dario0603/AudioAnalogMixer/README.md

# Analog Audio Mixer

<p align="left">
  
  
  
</p>

## Overview

Design and development of a **modular analog audio mixer**, combining circuit simulation and PCB design. The project focuses on audio signal conditioning, equalization, level control, and the integration of multiple input channels into a modular mixer architecture.

The design is divided into two main development areas:

- **LTspice simulations:** individual analog circuit blocks are simulated and evaluated before hardware implementation.
- **KiCad designs:** modular PCB boards are developed to organize the mixer circuitry into functional sections.

The current design includes microphone/line signal conditioning, a three-band equalizer, level and FX-send circuitry, a clipping indicator, and a four-channel mixer board.

The project is still under development. Circuit design, simulation, and PCB integration are ongoing, and the current files should be considered work in progress rather than a finalized hardware design.

## System Architecture

The mixer is organized into modular functional blocks. This approach makes it possible to develop and test each section independently before integrating the complete system.
The input stage provides microphone and line-level signal conditioning. Separate configurations are included for a single microphone/line channel and for two line-level channels, intended for left and right stereo signals.

The signal-conditioning section includes:

- Microphone/line preamplification.
- Three-band tone control.
- Output-level adjustment.
- FX-send circuitry.

### 1. Microphone/Line Preamplifier Circuit

The microphone/line preamplifier circuit provides input signal conditioning and amplification for low-level microphone signals and line-level audio sources. It is designed to adapt different input signal levels to the following stages of the mixer, ensuring proper signal amplification and compatibility with the audio processing circuitry.

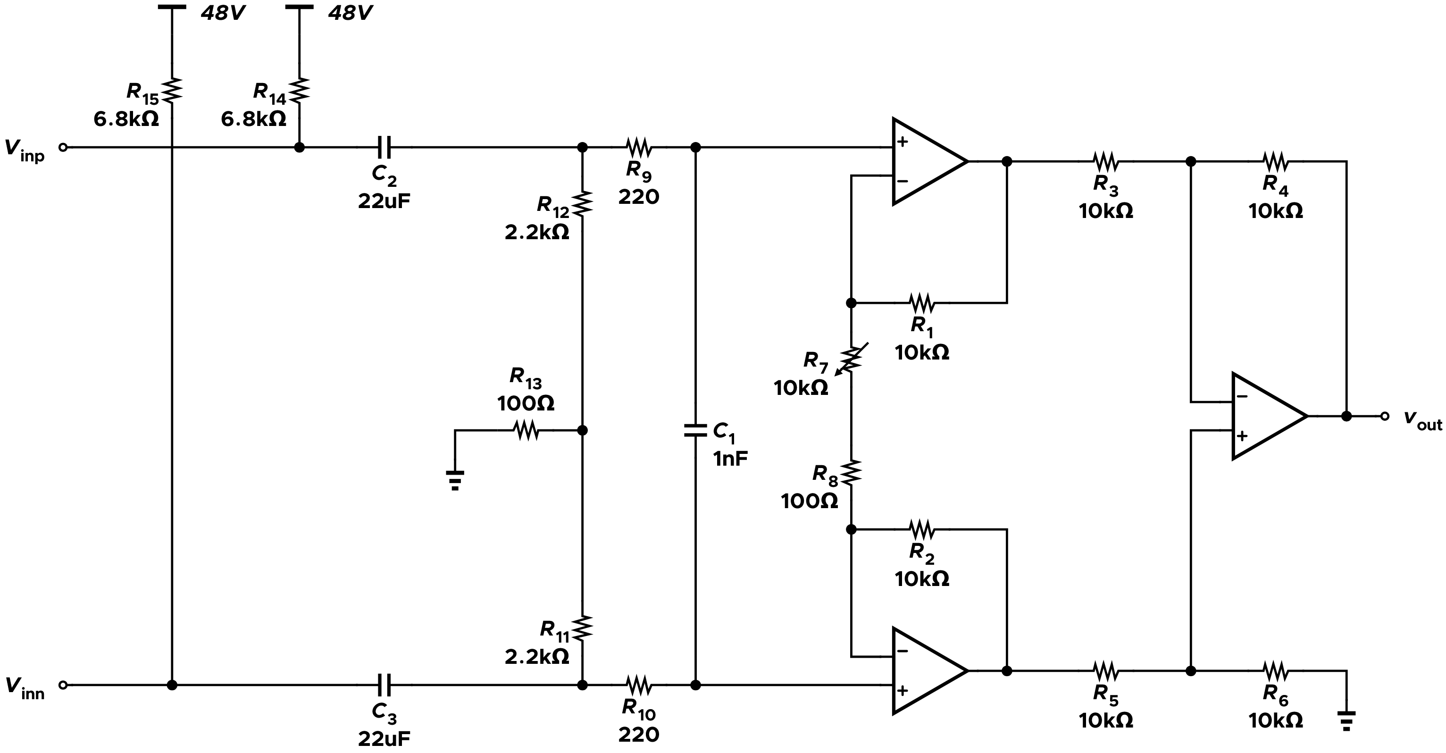
[picture p1: img/mic-line-amplifier.png]
Microphone and line amplifier


### 2. Three-Band Equalizer

The three-band equalizer provides independent control over the low-, mid-, and high-frequency portions of the audio spectrum.

The frequency response is evaluated through LTspice AC analysis. Different equalizer settings are compared to investigate how the circuit affects the audio signal across the frequency range.

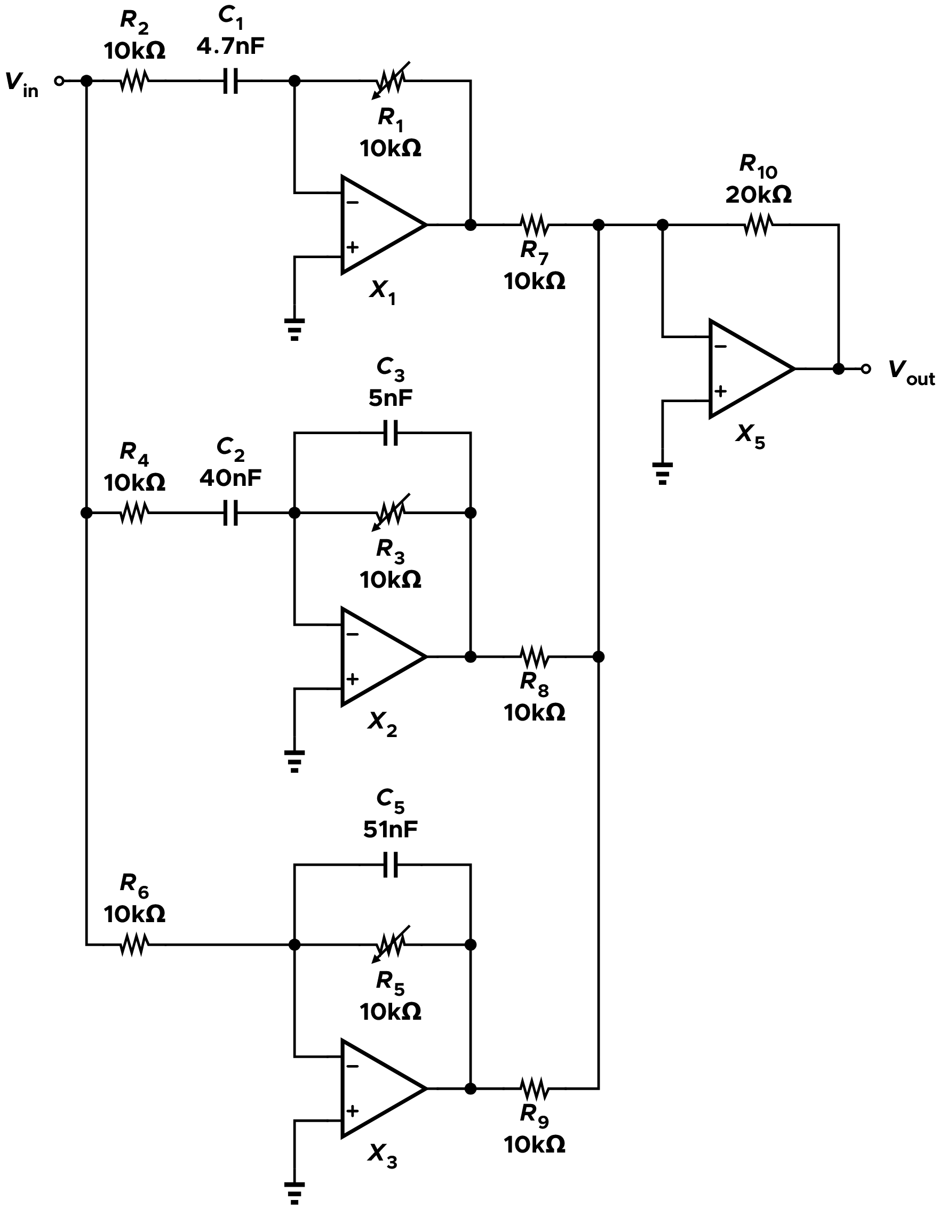
[picture p2: img/3-band-equalizer.png]
Three-band audio equalizer


### 3. Mixer Unit

This stage combines the signals processed by the input stages (microphone/line preamplifier and three-band equalizer), summing the individual channels to generate the final audio output. The output is provided in differential mode through two dedicated buffer amplifiers, ensuring proper signal driving capability and output impedance.

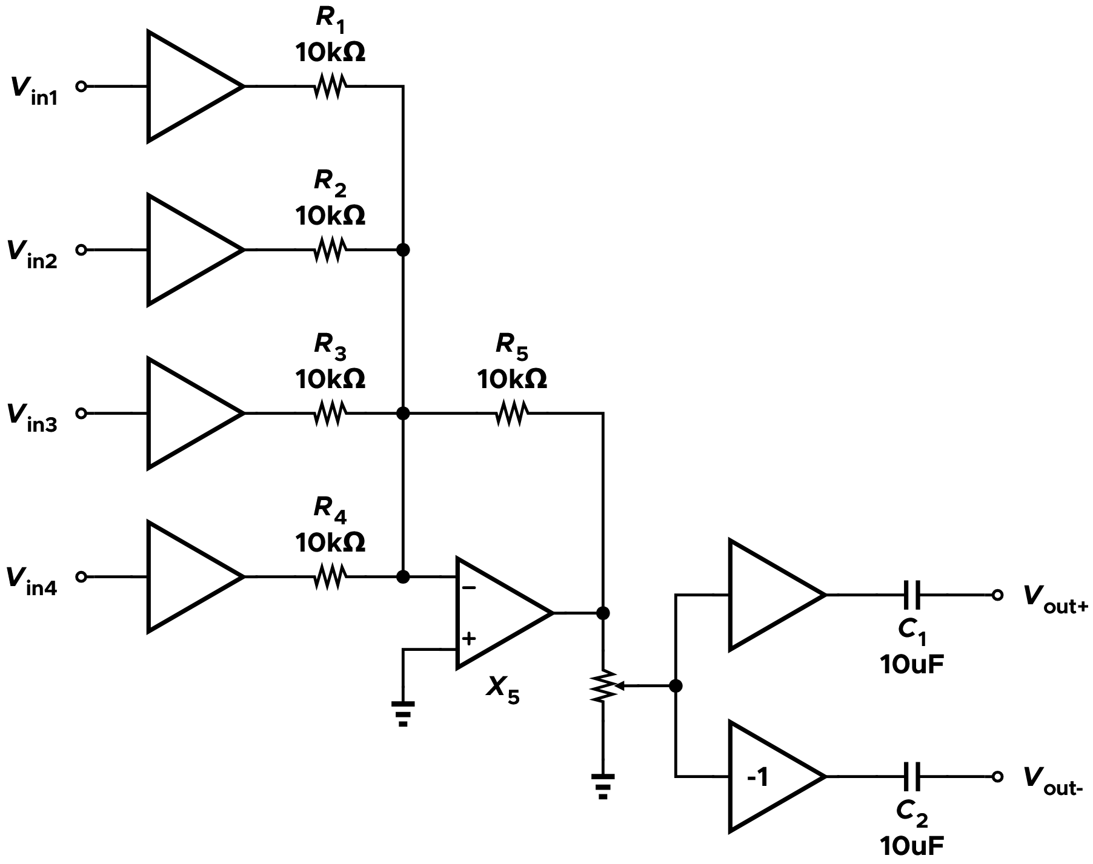
[picture p3: img/4channmixer.png]
Mixer unit


### 4. Clipping Indicator

A dedicated clipping-indicator circuit is included in the LTspice project.

The circuit uses an LM393 comparator model to detect signal levels approaching the selected clipping threshold. The output can be used to drive an LED, providing a visual indication of excessive signal amplitude.

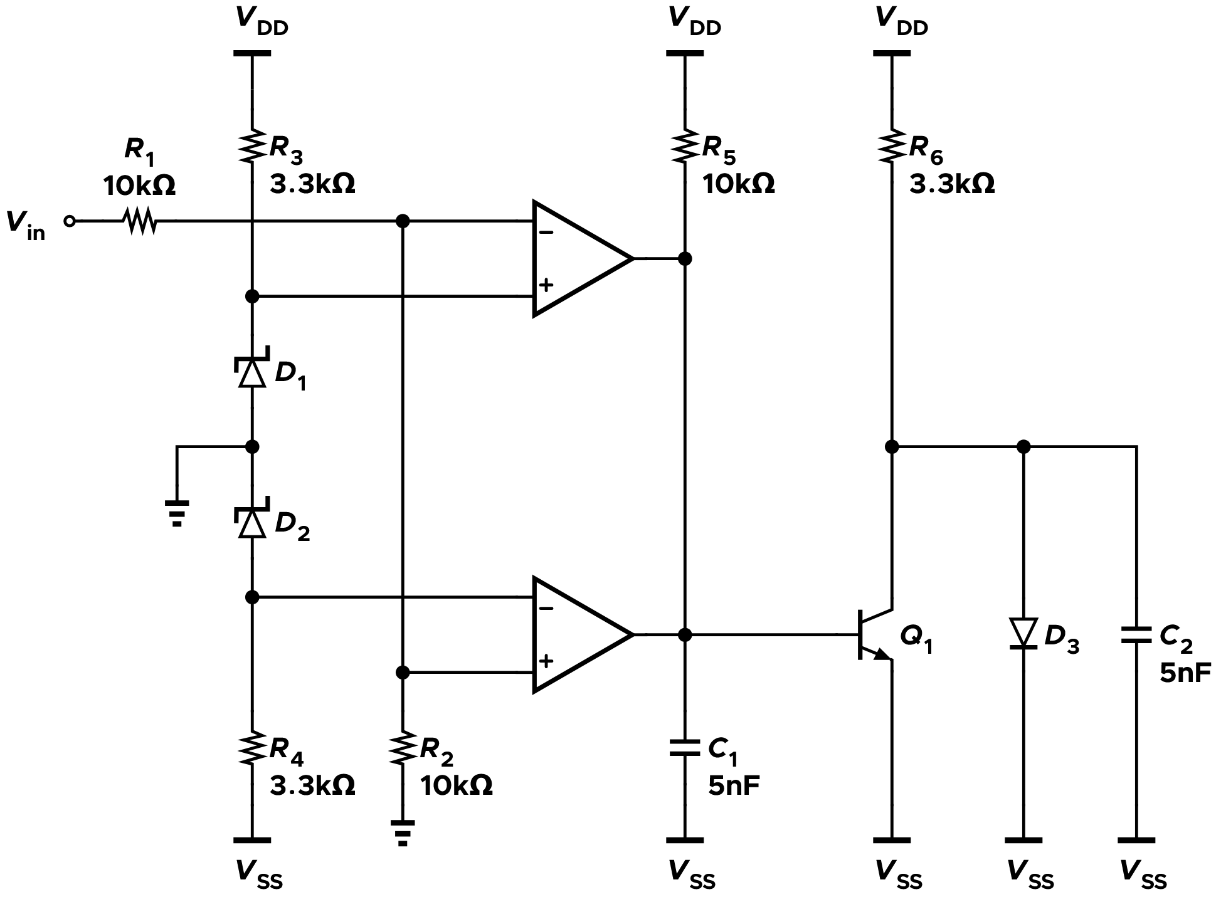
[picture p4: img/clippingledcircuit.png]
Microphone clipping LED circuit


The comparator circuit is simulated separately to allow its operation and threshold behavior to be evaluated independently of the complete mixer.

## Simulations

### 1. Three-Band Equalizer

**Frequency Response Analysis**

The frequency response of the three-band equalizer is analyzed for different control settings, including low-frequency, mid-frequency, and high-frequency attenuation.

| Low-frequency cut | Mid-frequency cut | High-frequency cut |
|:---:|:---:|:---:|
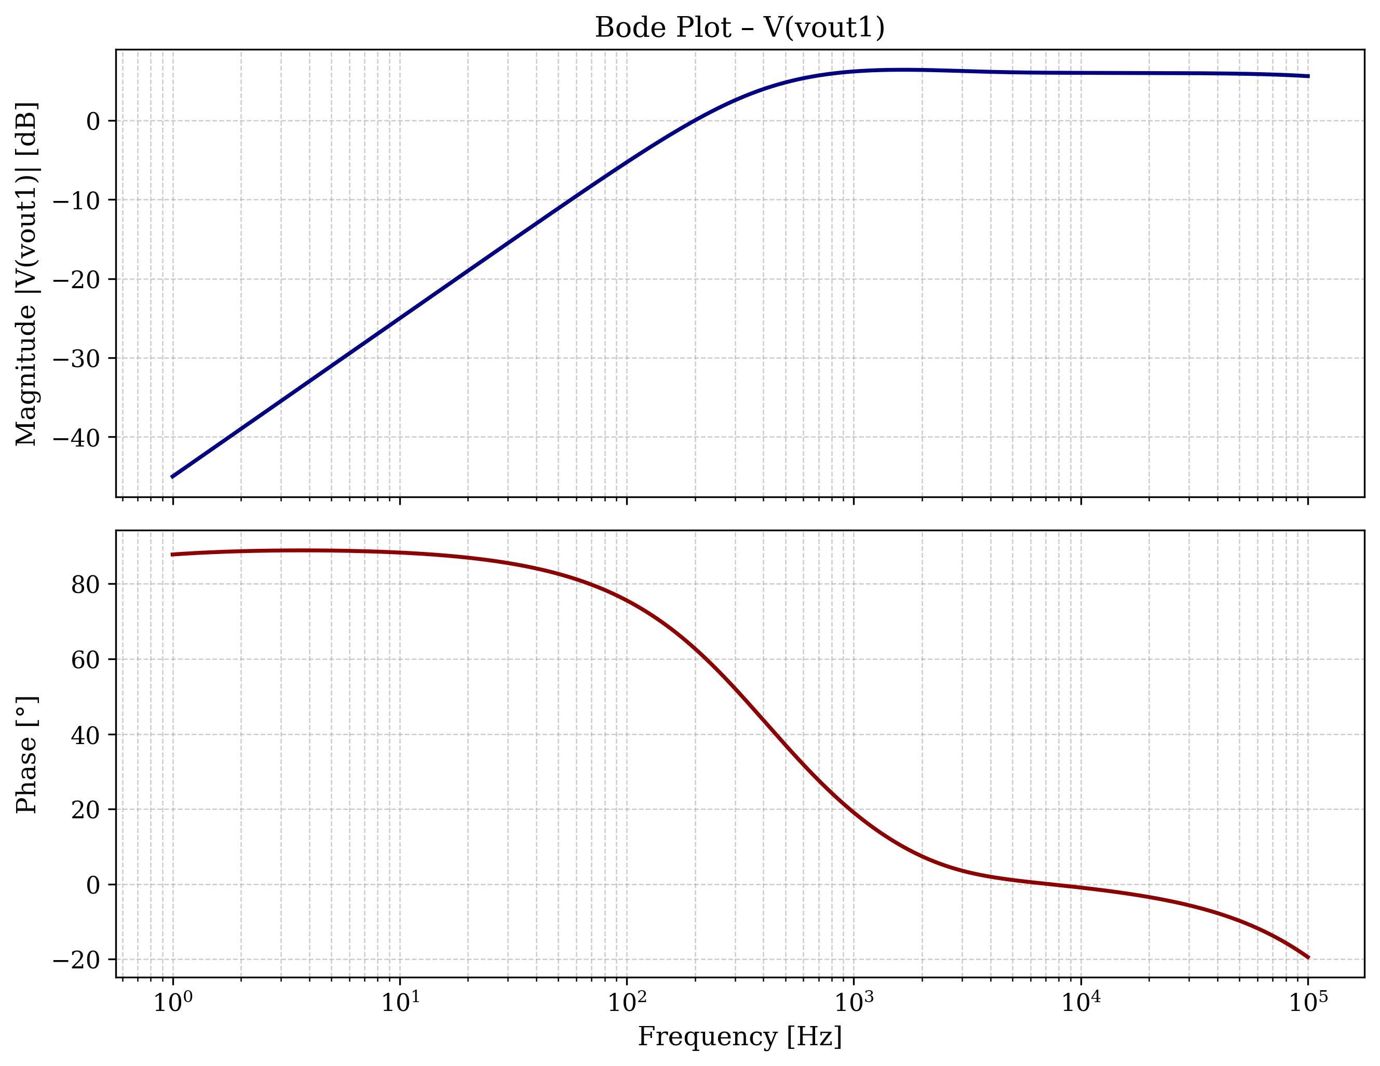
[picture p5: img/bode_diagram_low_cut.png]
Low-frequency cut
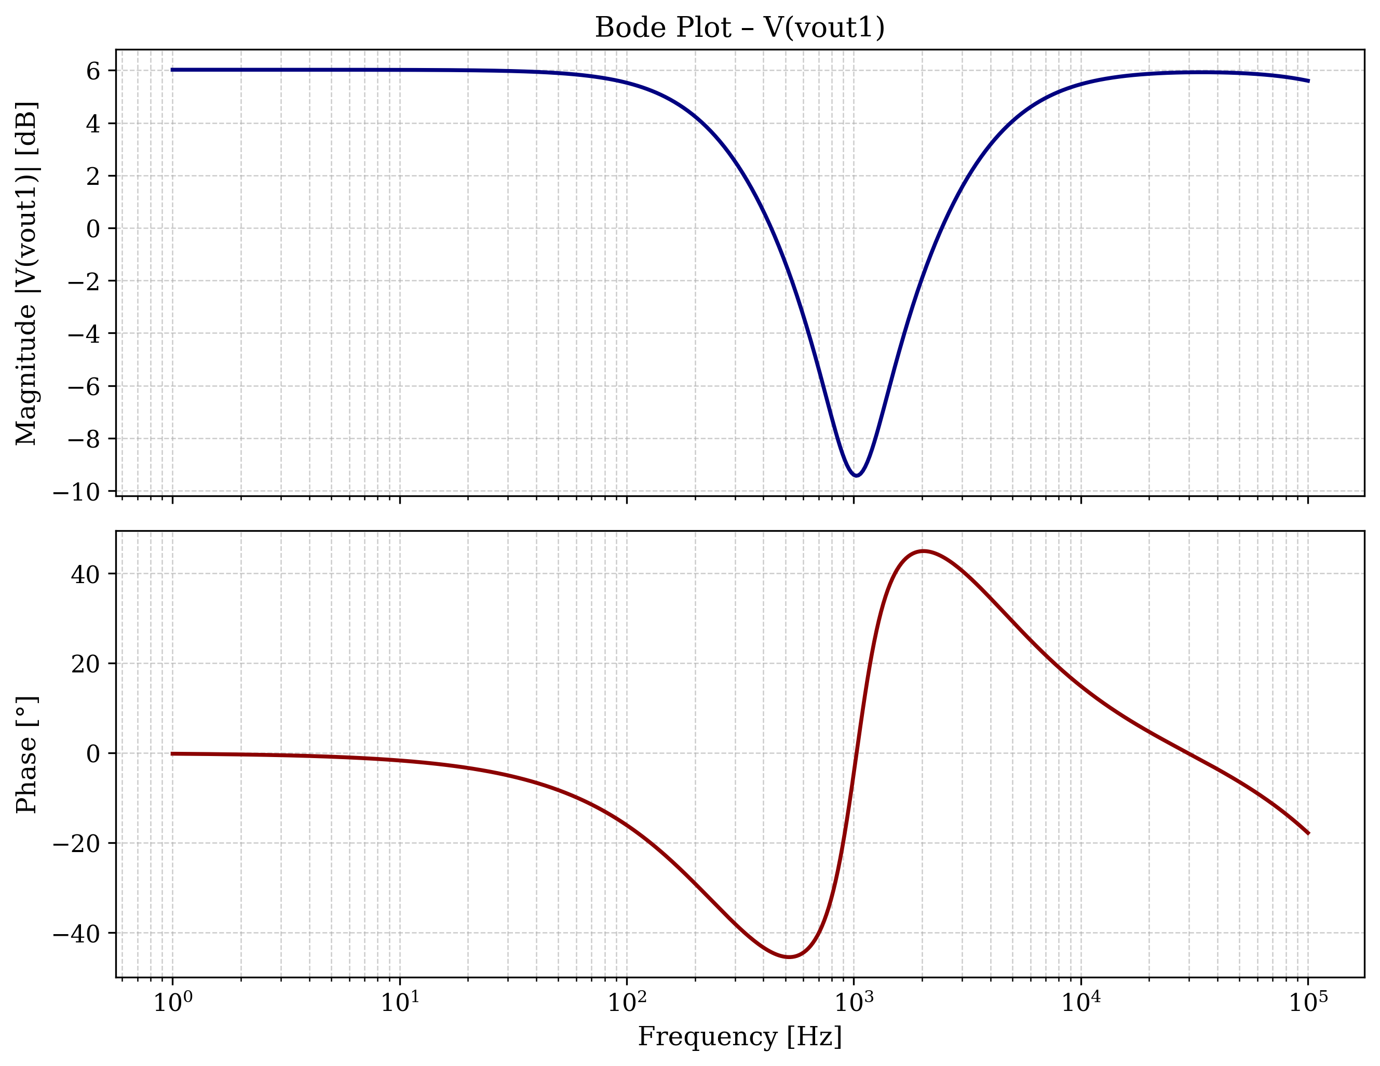
[picture p6: img/bode_diagram_medium_cut.png]
Mid-frequency cut
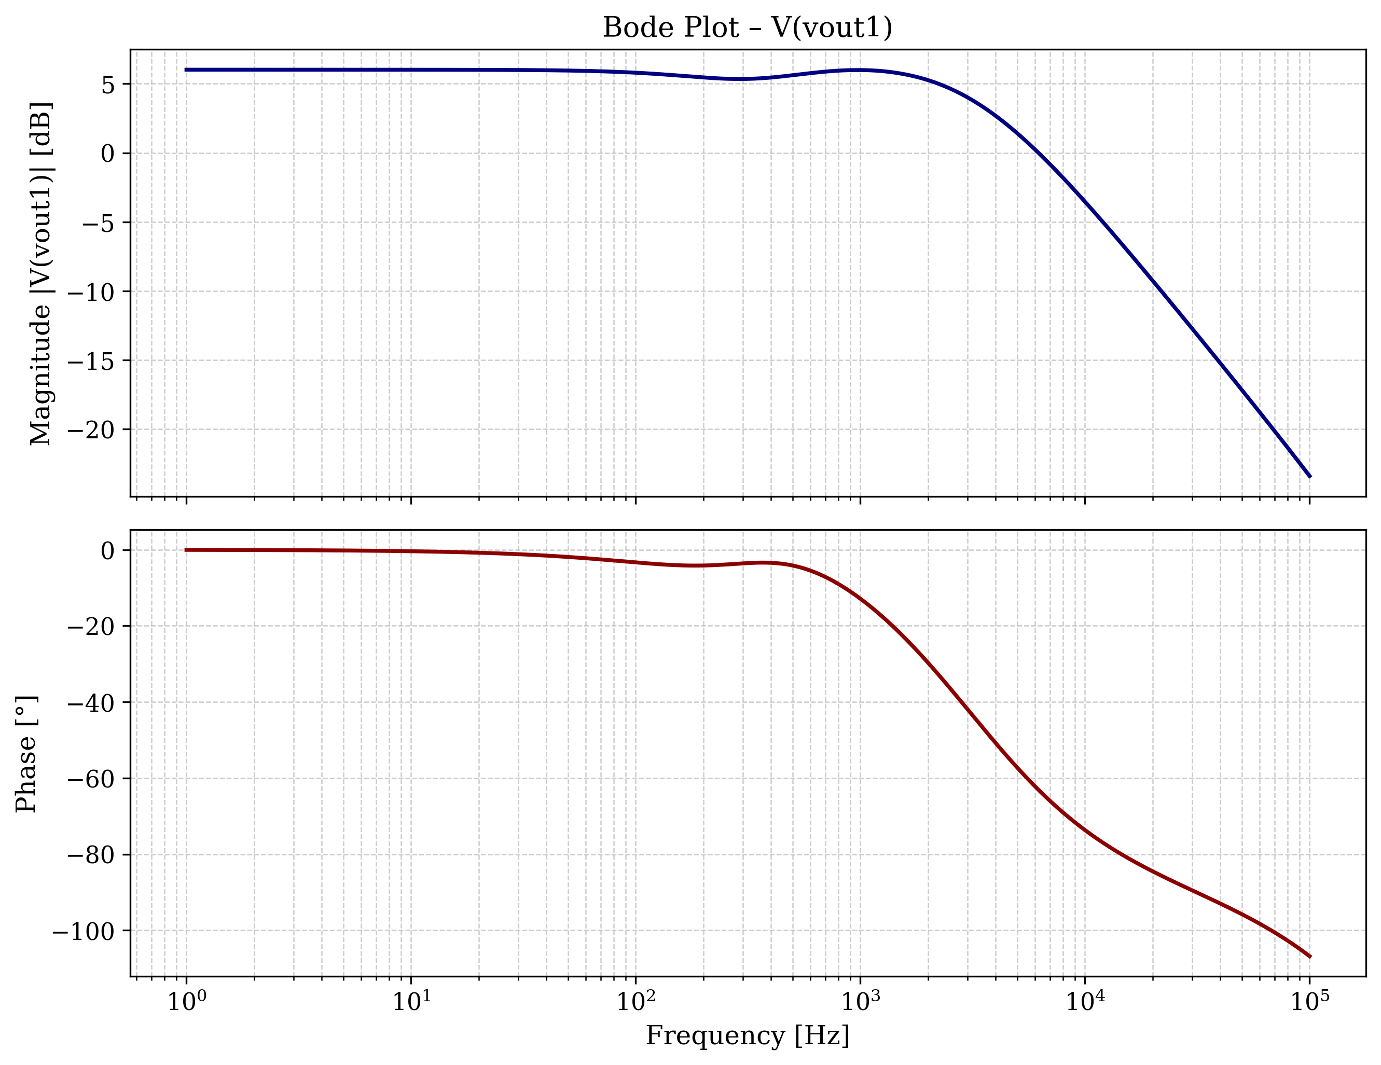
[picture p7: img/bode_diagram_high_cut.png]
High-frequency cut
|  |  |  |

**Flat Frequency Response Analysis**

The overall frequency response is evaluated with all equalizer controls set to their neutral positions.

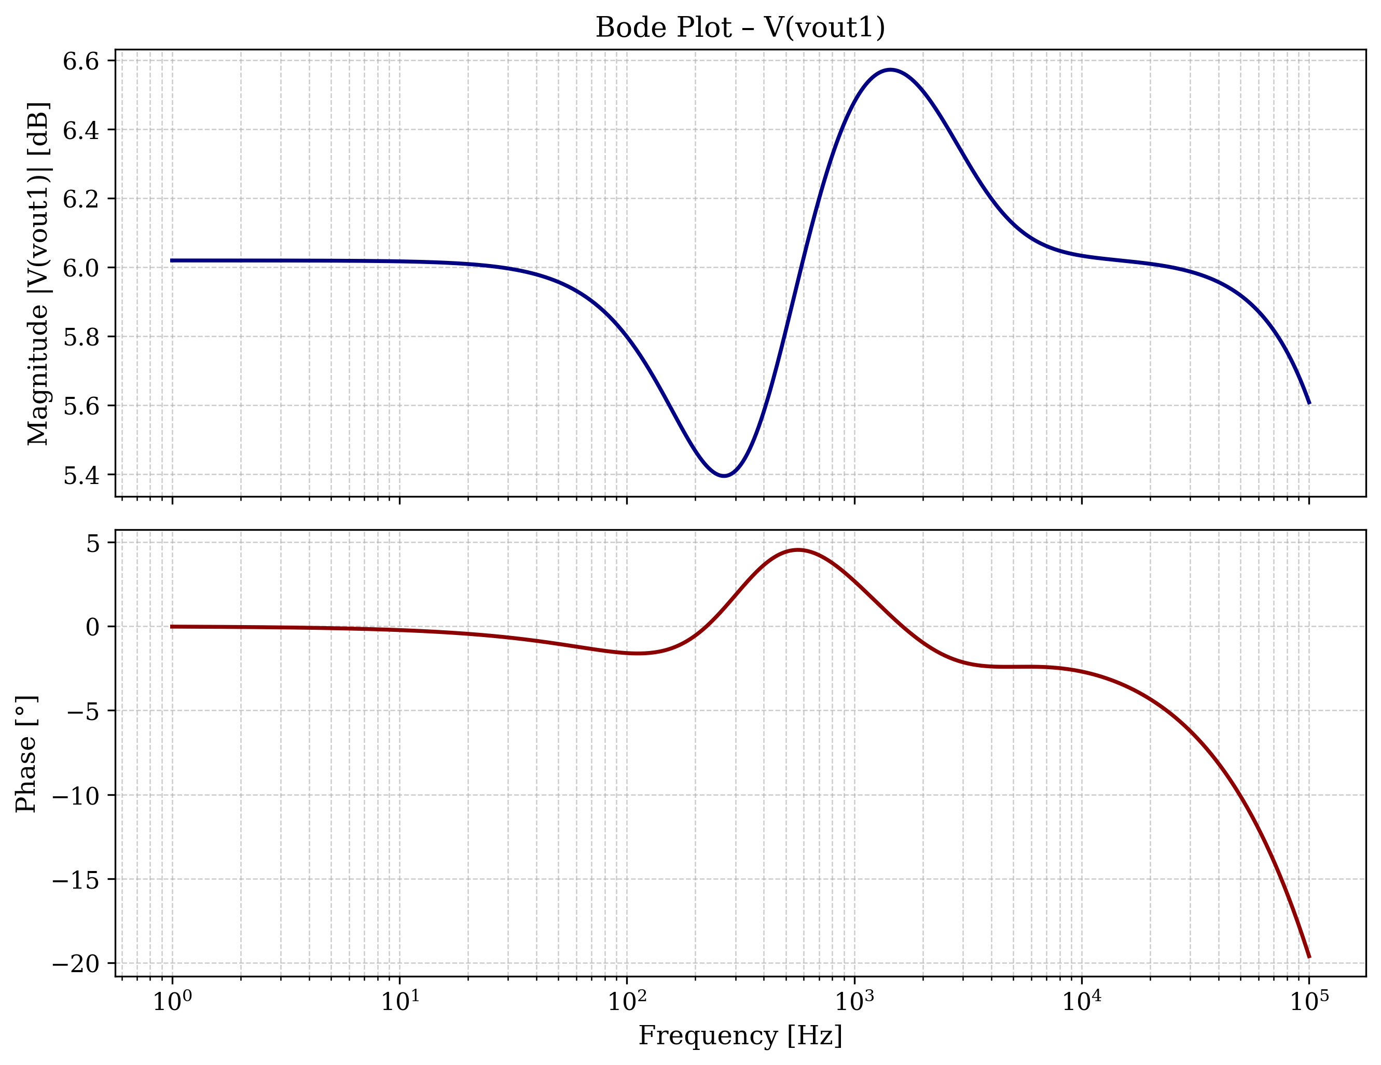
[picture p8: img/bode_diagram.png]
Frequency response without any cut frequency


**Monte Carlo Frequency Response Analysis**

A Monte Carlo analysis is performed to evaluate the effect of component tolerances on the equalizer response, considering 1% resistor tolerances (0603 package) and 10% ceramic X7R capacitor tolerances.

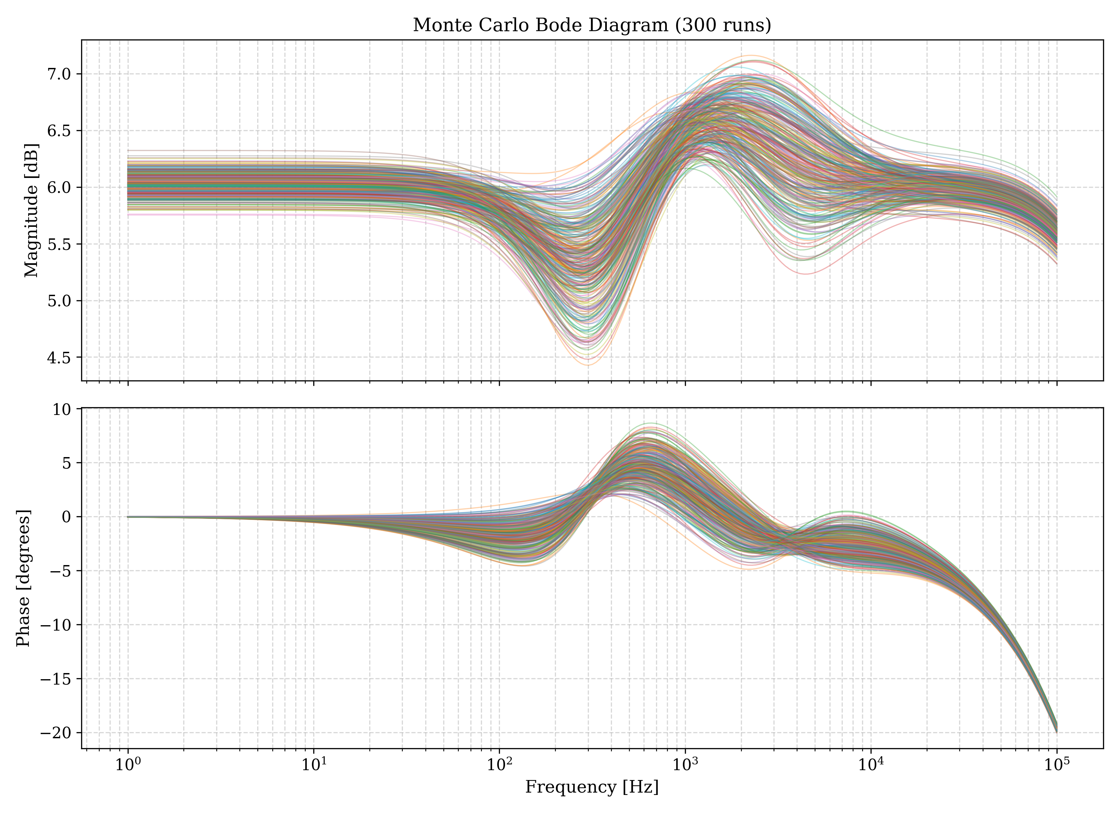
[picture p9: img/AudioMixer - 3bEq_bode_montecarlo.png]
Monte Carlo frequency response without any cutoff frequency


### 2. Microphone/Line Preamplifier

**AC Frequency Response Analysis**

The frequency response of the line and XLR preamplifier configurations is evaluated through LTspice AC analysis to characterize their behavior across the audio frequency range.

**Line Preamplifier:**

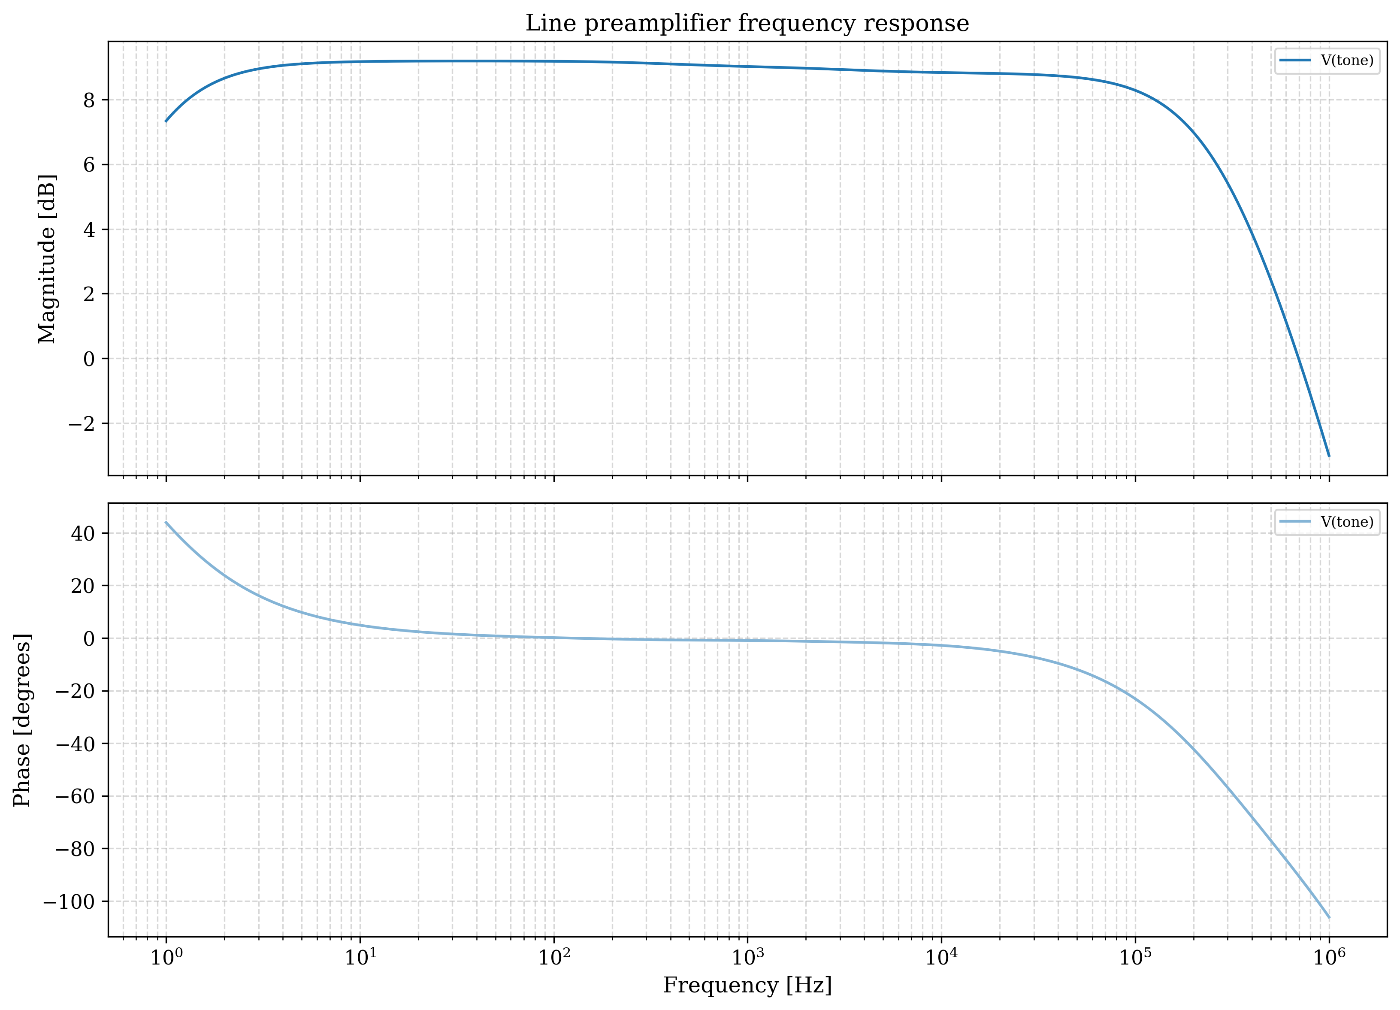
[picture p10: img/Line preamplifier frequency response.png]
Line preamplifier frequency response


**XLR Preamplifier:**

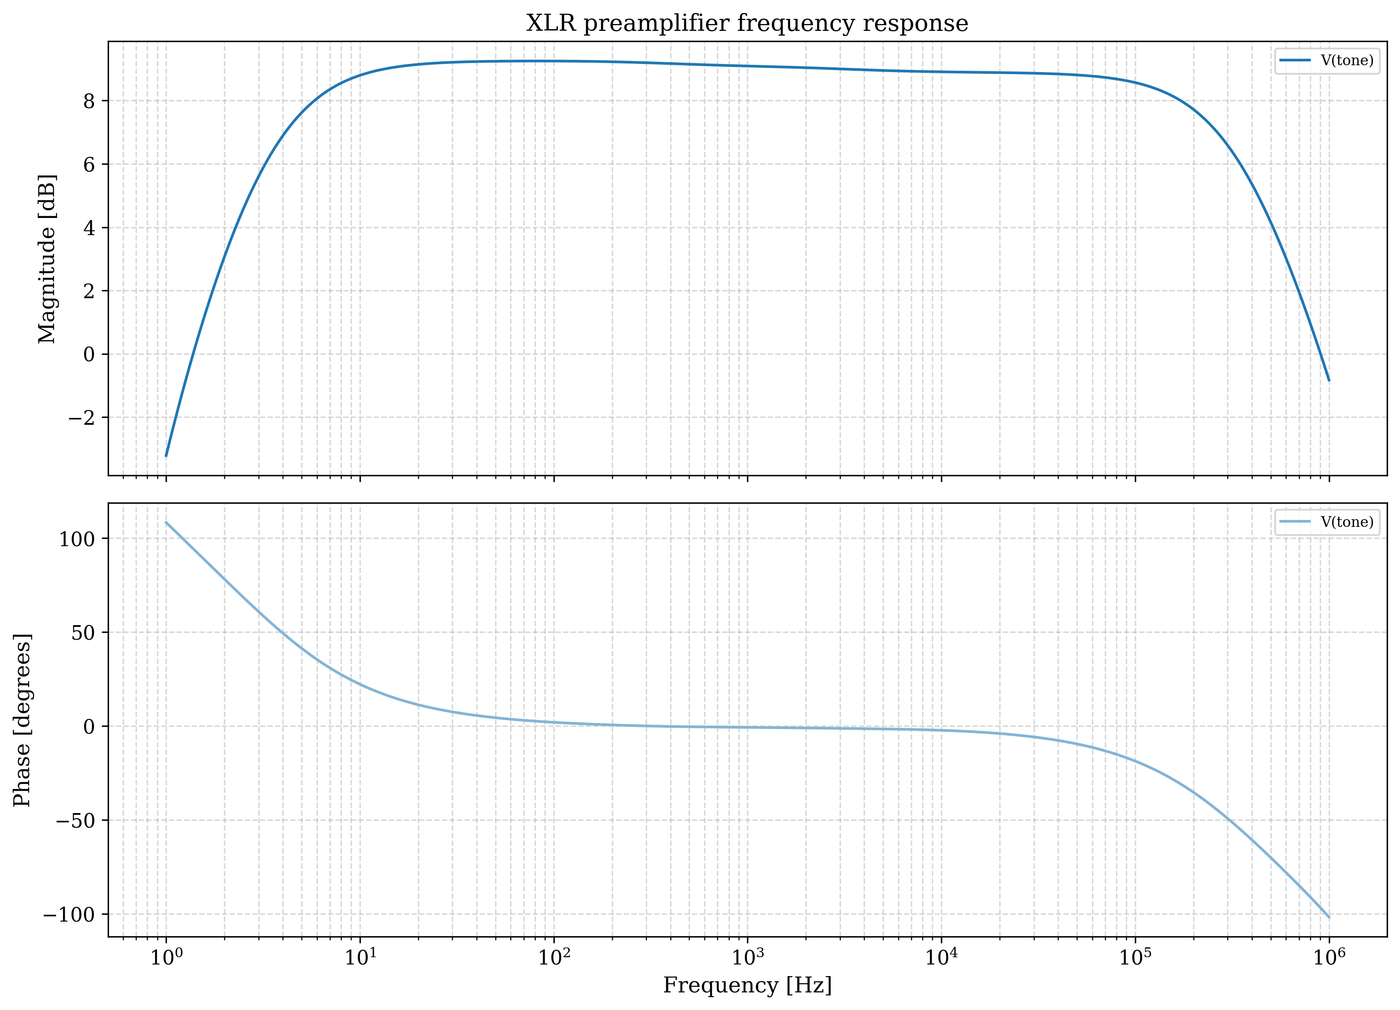
[picture p11: img/XLR preamplifier frequency response.png]
XLR preamplifier frequency response


**Transient Response Analysis – 5 kHz Differential Input**

A 5 kHz differential sinusoidal signal is applied to the XLR preamplifier to evaluate its transient response under maximum and minimum gain configurations.

**Input Signal:**

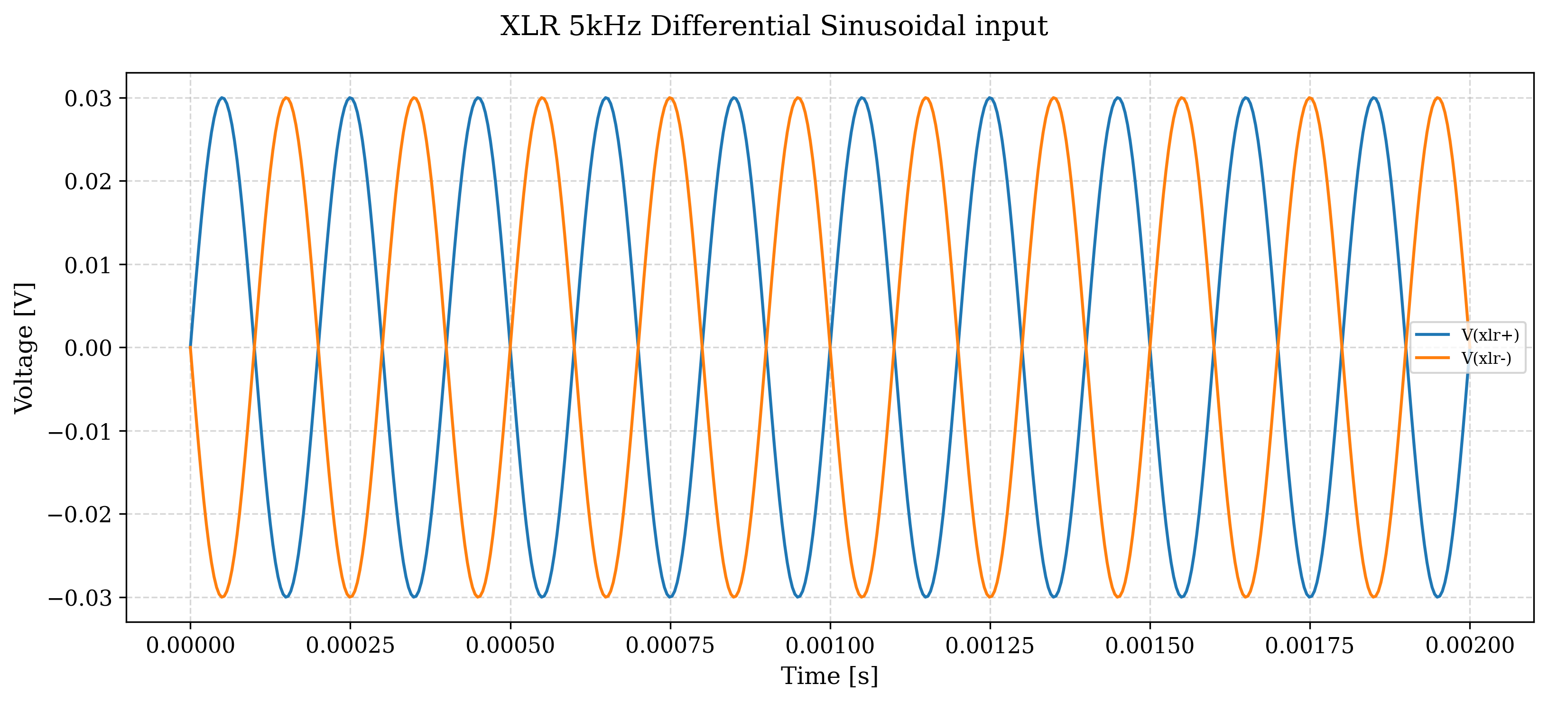
[picture p12: img/XLR 5kHz Differential Sinusoidal input.png]
XLR 5 kHz differential sinusoidal input


**Maximum Gain Configuration:**

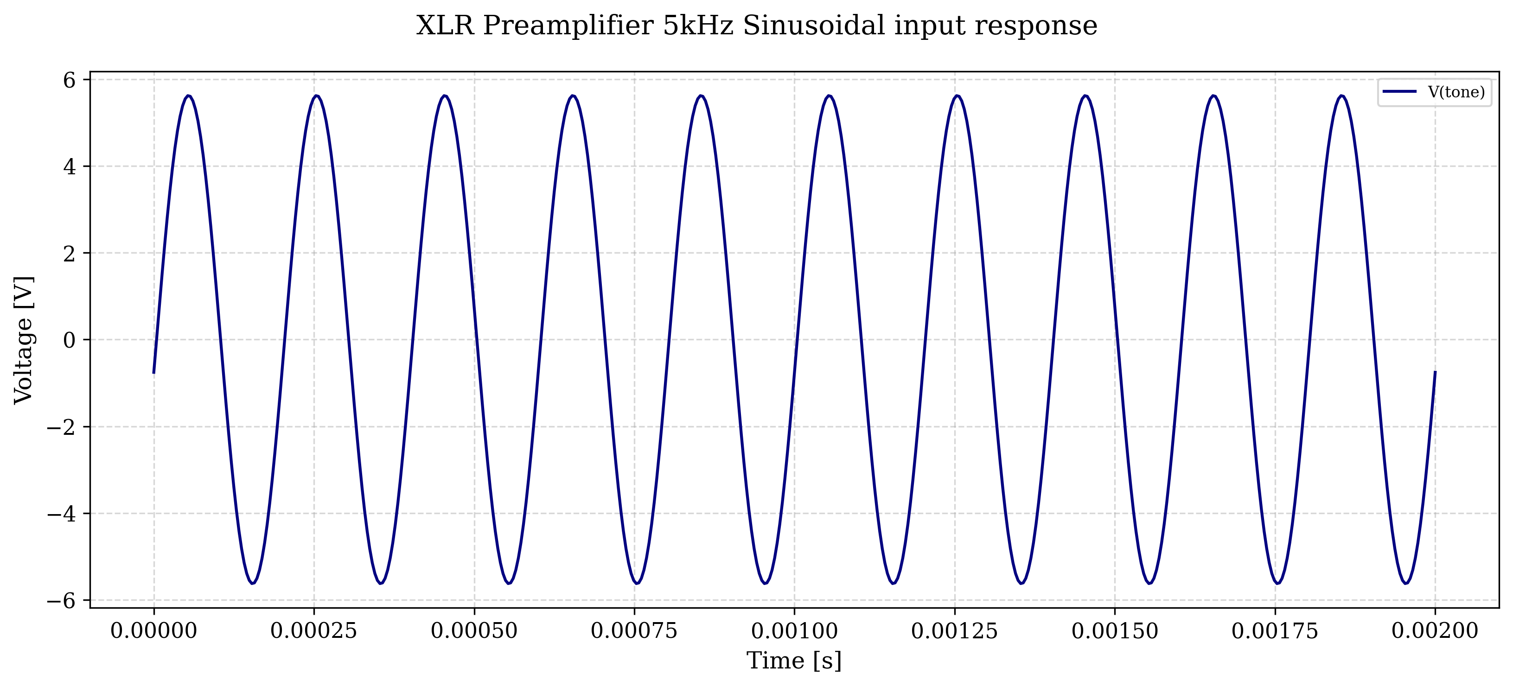
[picture p13: img/XLR Preamplifier 5kHz Sinusoidal input response Gmax.png]
XLR preamplifier 5 kHz sinusoidal input response maximum gain


**Minimum Gain Configuration:**

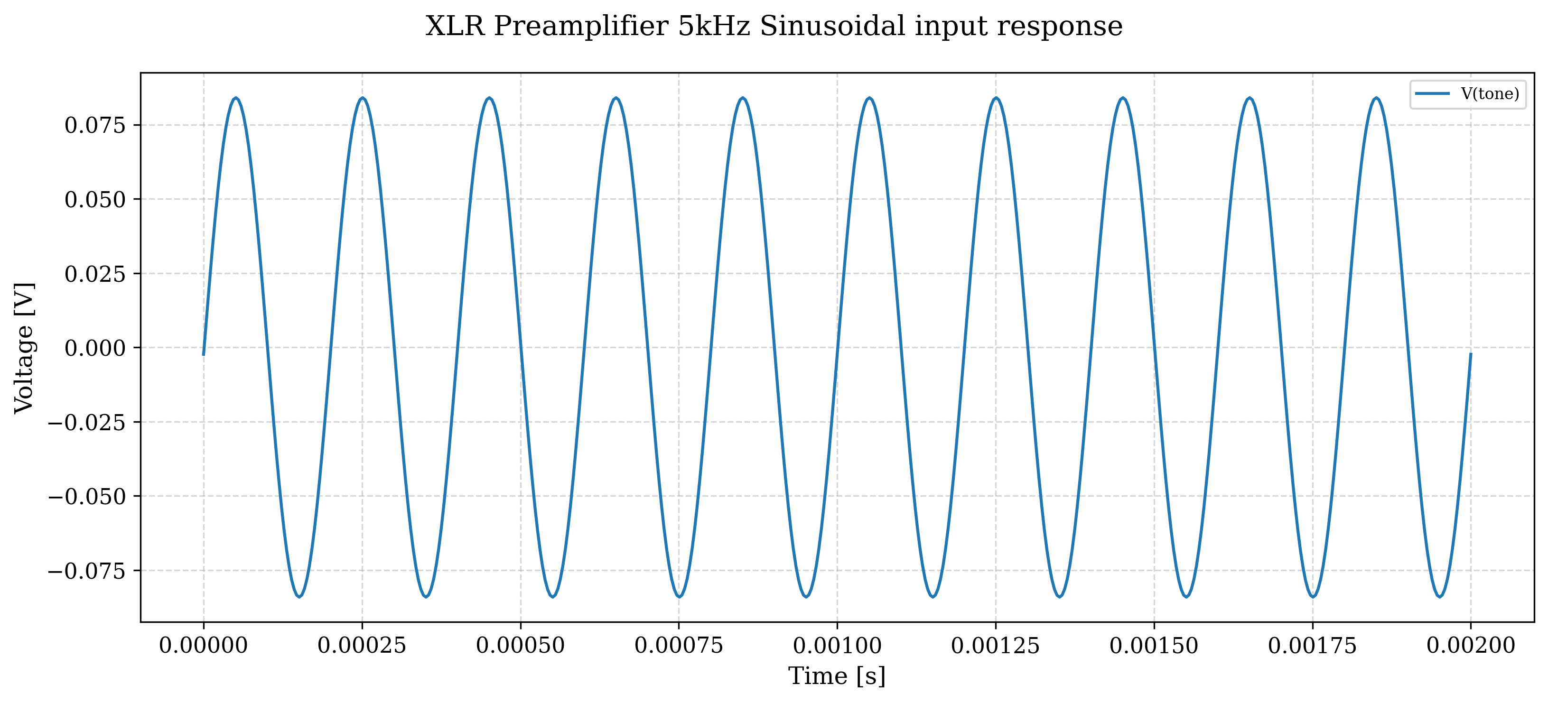
[picture p14: img/XLR Preamplifier 5kHz Sinusoidal input response Gmin.png]
XLR preamplifier 5 kHz sinusoidal input response minimum gain


**Monte Carlo Transient Analysis**

A Monte Carlo simulation consisting of 300 runs is performed to evaluate the variability of the XLR preamplifier transient response due to component tolerances, considering both maximum and minimum gain configurations.

**Maximum Gain Configuration:**

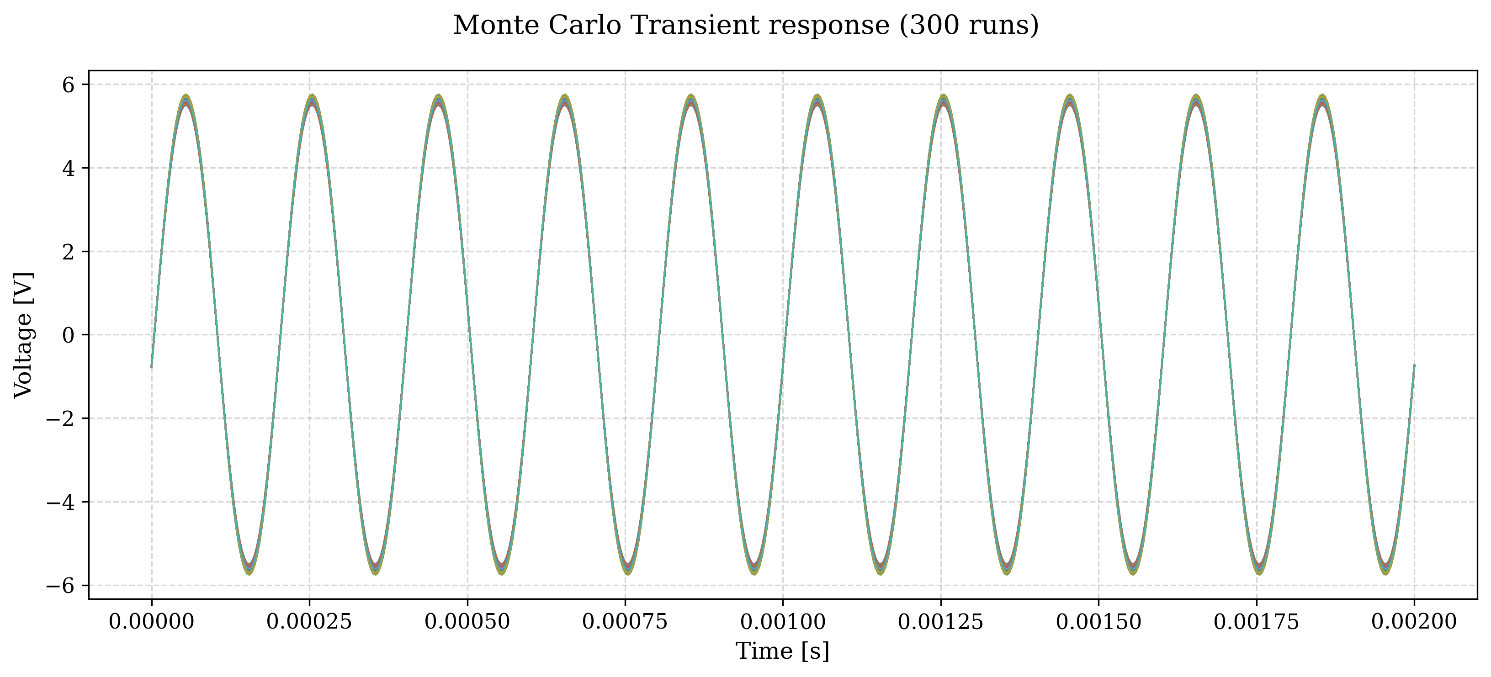
[picture p15: img/Mic-Line-Amp_transientMontecarlo Gmax.png]
Microphone line amplifier transient Monte Carlo maximum gain


**Minimum Gain Configuration:**

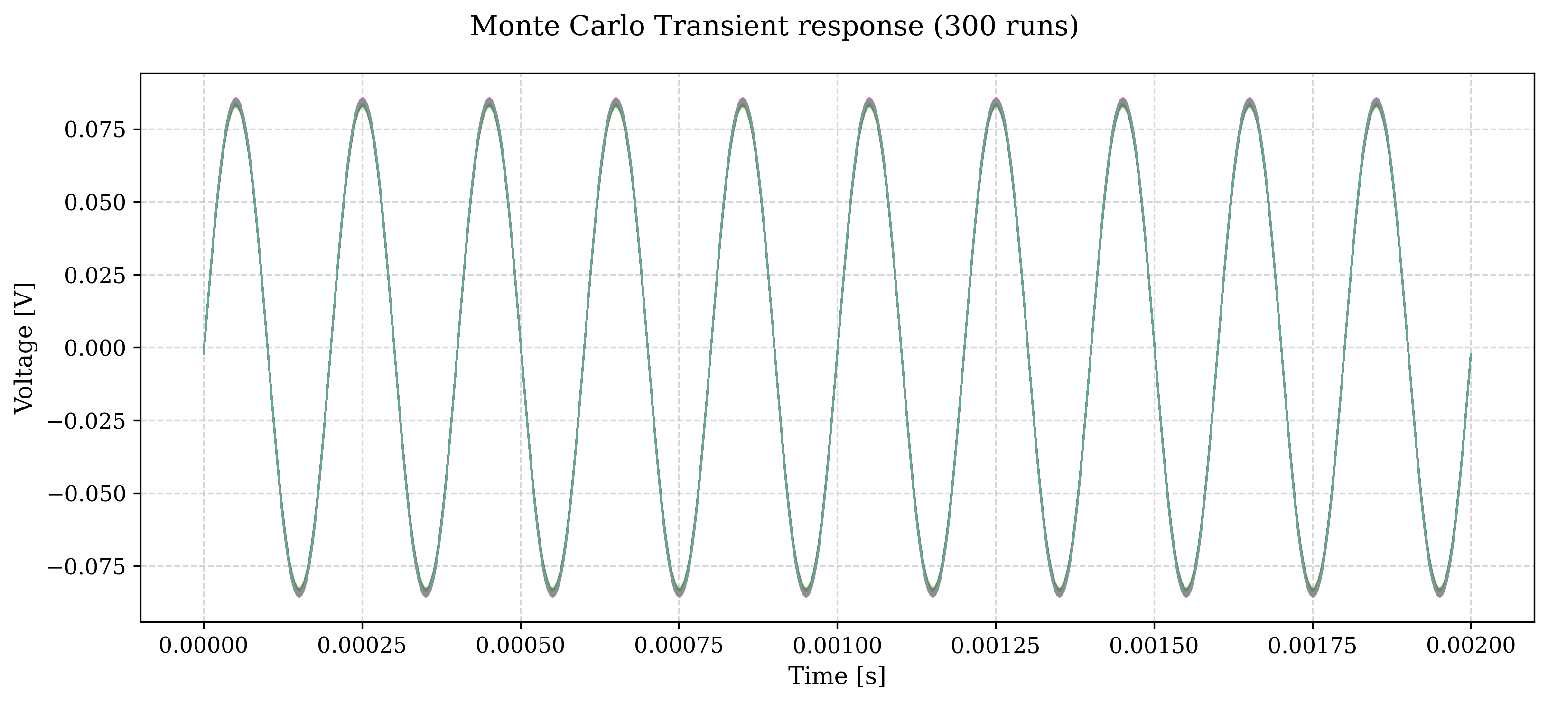
[picture p16: img/Mic-Line-Amp_transientMontecarlo Gmin.png]
Microphone line amplifier transient Monte Carlo minimum gain


**Noise Analysis**

LTspice noise analysis is performed to evaluate the output noise spectral density of the preamplifier stages. Different operational-amplifier configurations are compared to investigate their noise contributions.

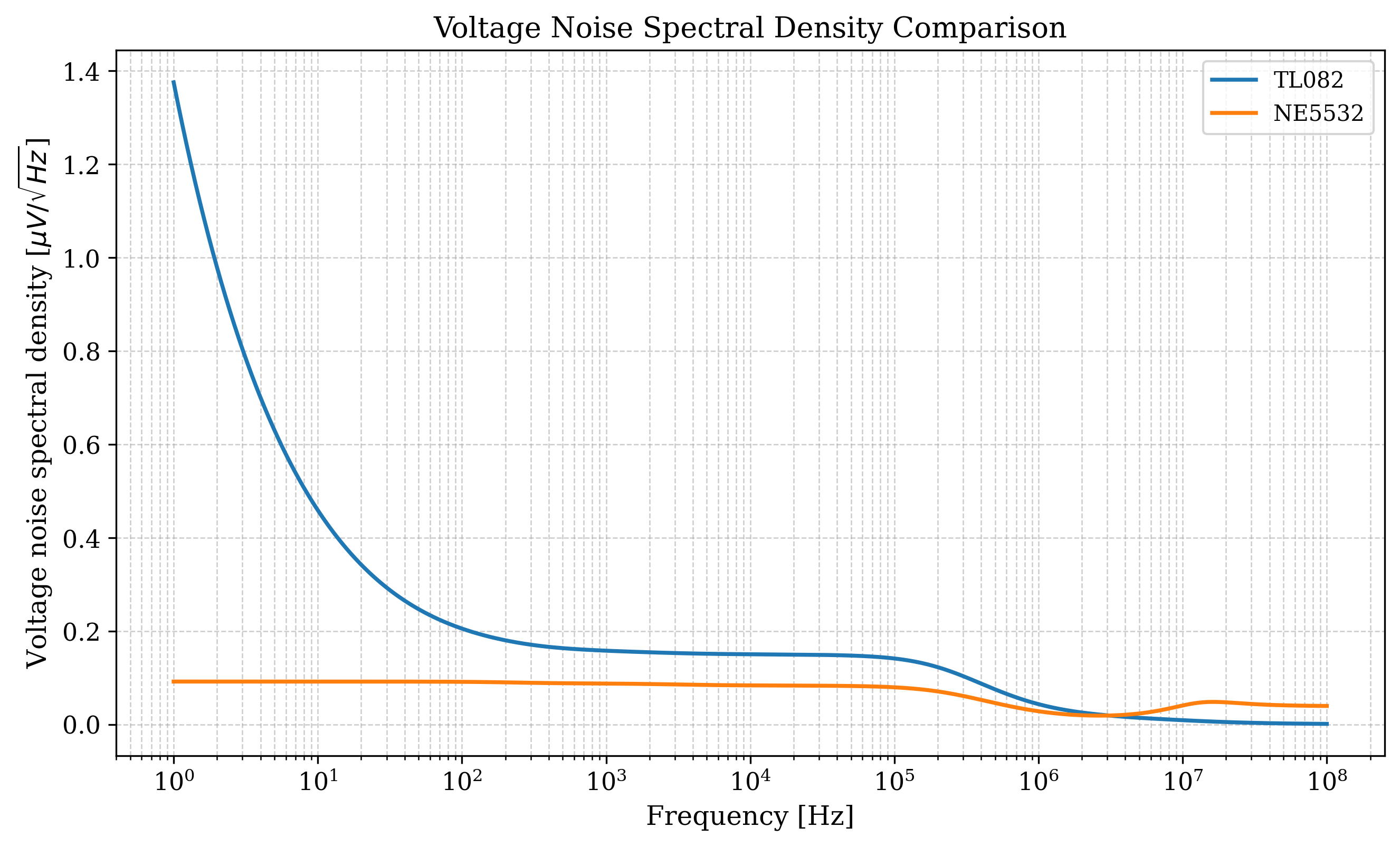
[picture p17: img/noise_comparison.png]
Noise spectral density comparison


The noise simulations are still being refined, particularly regarding the accuracy of the operational-amplifier noise models and their consistency with datasheet specifications.

### 3. Mixer

**Transient Response Analysis**

Transient simulations are performed to evaluate the time-domain behavior of the mixer circuit.

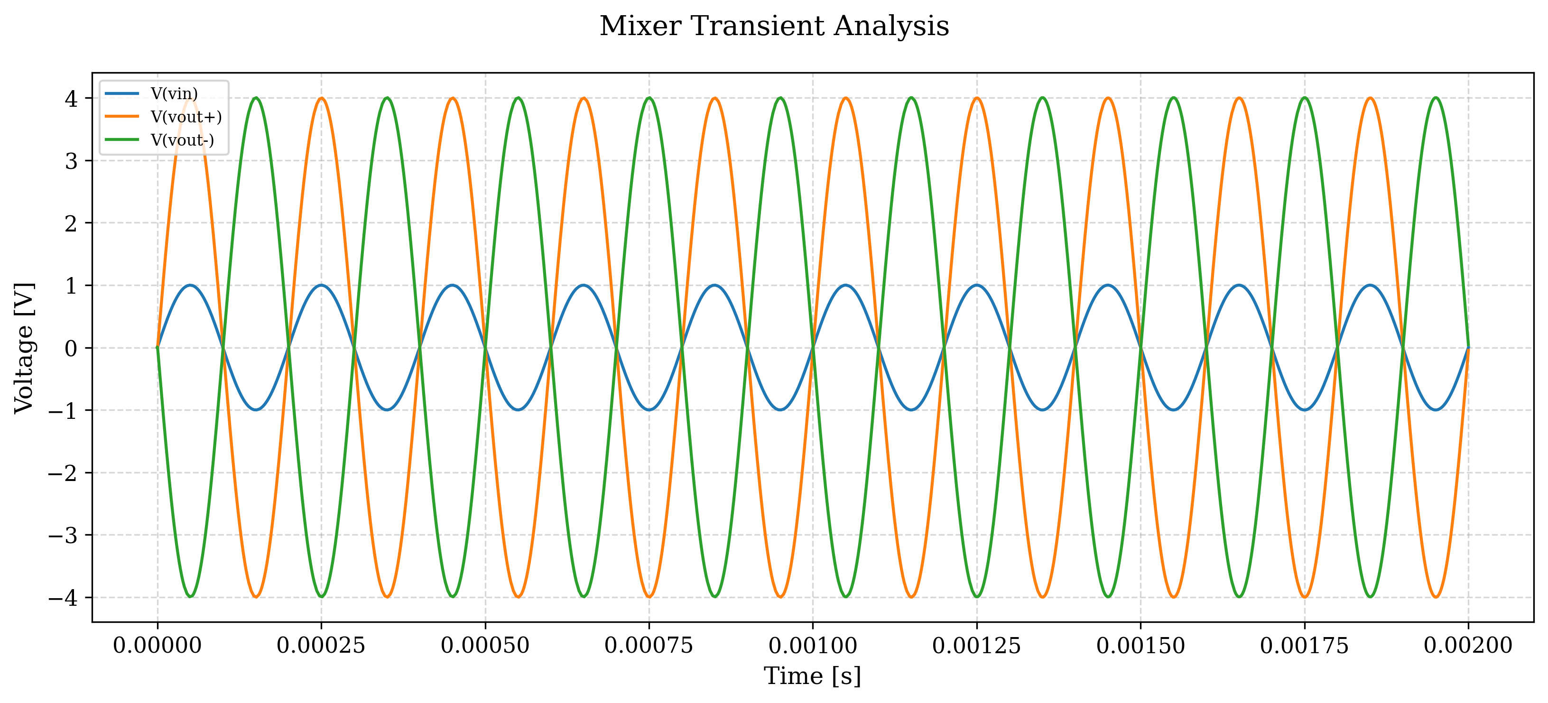
[picture p18: img/Mixer Transient Analysis.png]
Mixer Transient Analysis


**Monte Carlo Transient Analysis**

A Monte Carlo simulation consisting of 300 runs is performed to investigate output voltage variations caused by component tolerances.

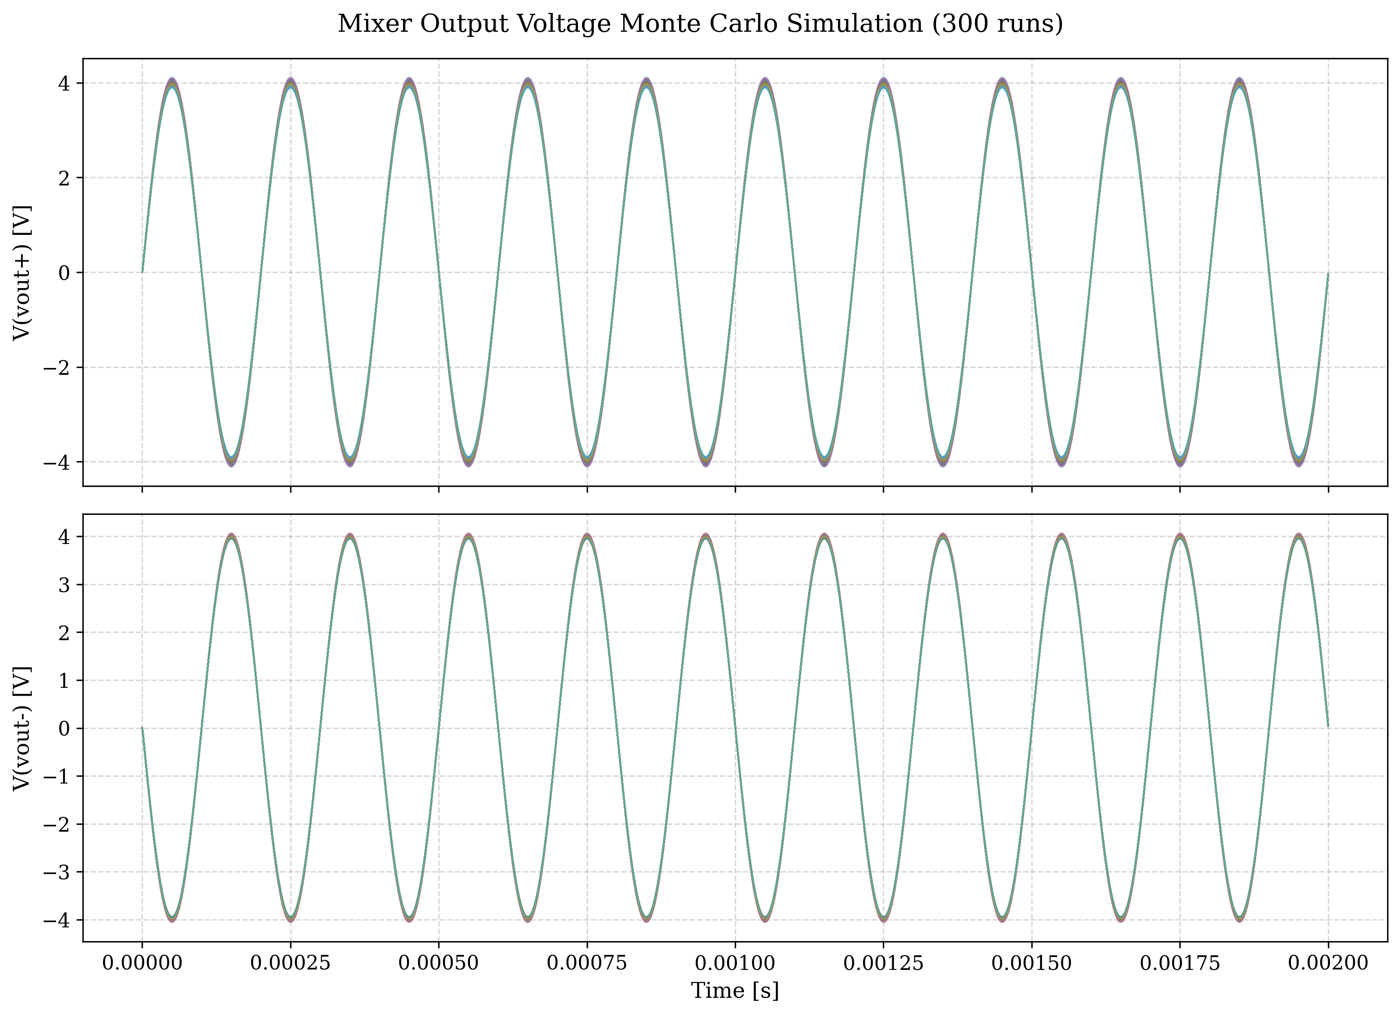
[picture p19: img/Mixer Output Voltage Monte Carlo Simulation (300 runs).png]
Mixer Output Voltage Monte Carlo Simulation (300 runs)


## PCB Design

The PCB development is carried out in KiCad. The modular approach separates the main mixer board from the input signal-conditioning circuitry.

### 1. Four-Channel Mixer Board

The `4ChannelMixerBoard` project contains the PCB design and schematic for the four-channel mixer board.

The board is intended to provide the central platform for combining the individual audio channels.

### 2. Single-Channel Microphone/Line Board

The `SignalConditioning - OneChannel - Mic-Line` project contains the signal-conditioning design for a single microphone/line input channel.
The PCB layout brings the microphone/line preamplifier, three-band equalizer, level and FX-send circuitry, and power supply together on a single board.

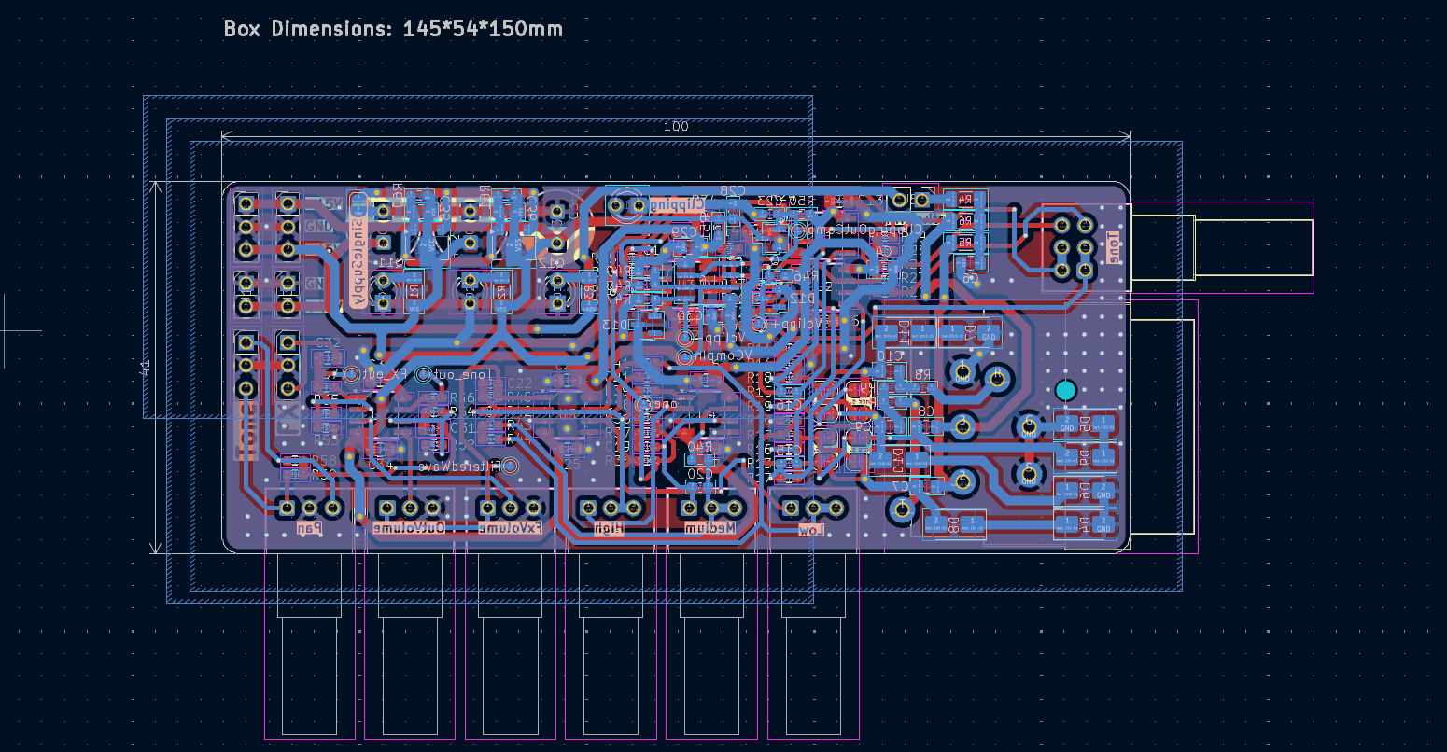
[picture p20: img/SignalConditioning - OneChannel - Mic-Line PCB.png]
Single-channel microphone/line signal-conditioning PCB


The project includes the following schematic sections:

- Microphone/line preamplifier.
- Three-band equalizer.
- Level control and FX-send circuitry.
- Power supply.

### 3. Two-Channel Line Board

The `SignalConditioning - TwoChannels - R-L-Line` project contains a two-channel signal-conditioning configuration intended for right and left line-level signals.

Its schematic is organized around the same functional blocks as the single-channel version, adapted for a stereo input configuration.

The PCB layouts and circuit integration are still under development. Further work is required to complete the board designs and verify their operation in hardware.

## Repository Structure

```text
.
├── README.md
│
├── AudioMixer - LTSpice/
│   ├── 3bEq/
│   │   ├── AudioMixer - 3bEq.asc
│   │   ├── NE5532.sub
│   │   └── Montecarlo/
│   │
│   ├── ClippingLed/
│   │   ├── ClippingLed.asc
│   │   └── lm393.lib
│   │
│   └── Mic-Line amplifier/
│       ├── AudioMixer - Mic-Line-amp.asc
│       └── NE5532.sub
│
├── AudioMixer - ModularBoards/
│   ├── spec.txt
│   │
│   ├── 4ChannelMixerBoard/
│   │   ├── Mixer_circuit.kicad_pro
│   │   ├── Mixer_circuit.kicad_sch
│   │   └── Mixer_circuit.kicad_pcb
│   │
│   ├── SignalConditioning - OneChannel - Mic-Line/
│   │   ├── AudioMixer.kicad_pro
│   │   ├── AudioMixer.kicad_sch
│   │   ├── AudioMixer.kicad_pcb
│   │   ├── Mic-Line_preamp.kicad_sch
│   │   ├── 3_band_equalizer.kicad_sch
│   │   ├── Level_and_FXSend.kicad_sch
│   │   └── Power_supply.kicad_sch
│   │
│   └── SignalConditioning - TwoChannels - R-L-Line/
│       ├── AudioMixer.kicad_pro
│       ├── AudioMixer.kicad_sch
│       ├── AudioMixer.kicad_pcb
│       ├── Mic-Line_preamp.kicad_sch
│       ├── 3_band_equalizer.kicad_sch
│       ├── Level_and_FXSend.kicad_sch
│       └── Power_supply.kicad_sch
│
└── img/
```
