dario0603/AudioAnalogMixer/img/Mixer Bode Transfer Function.png

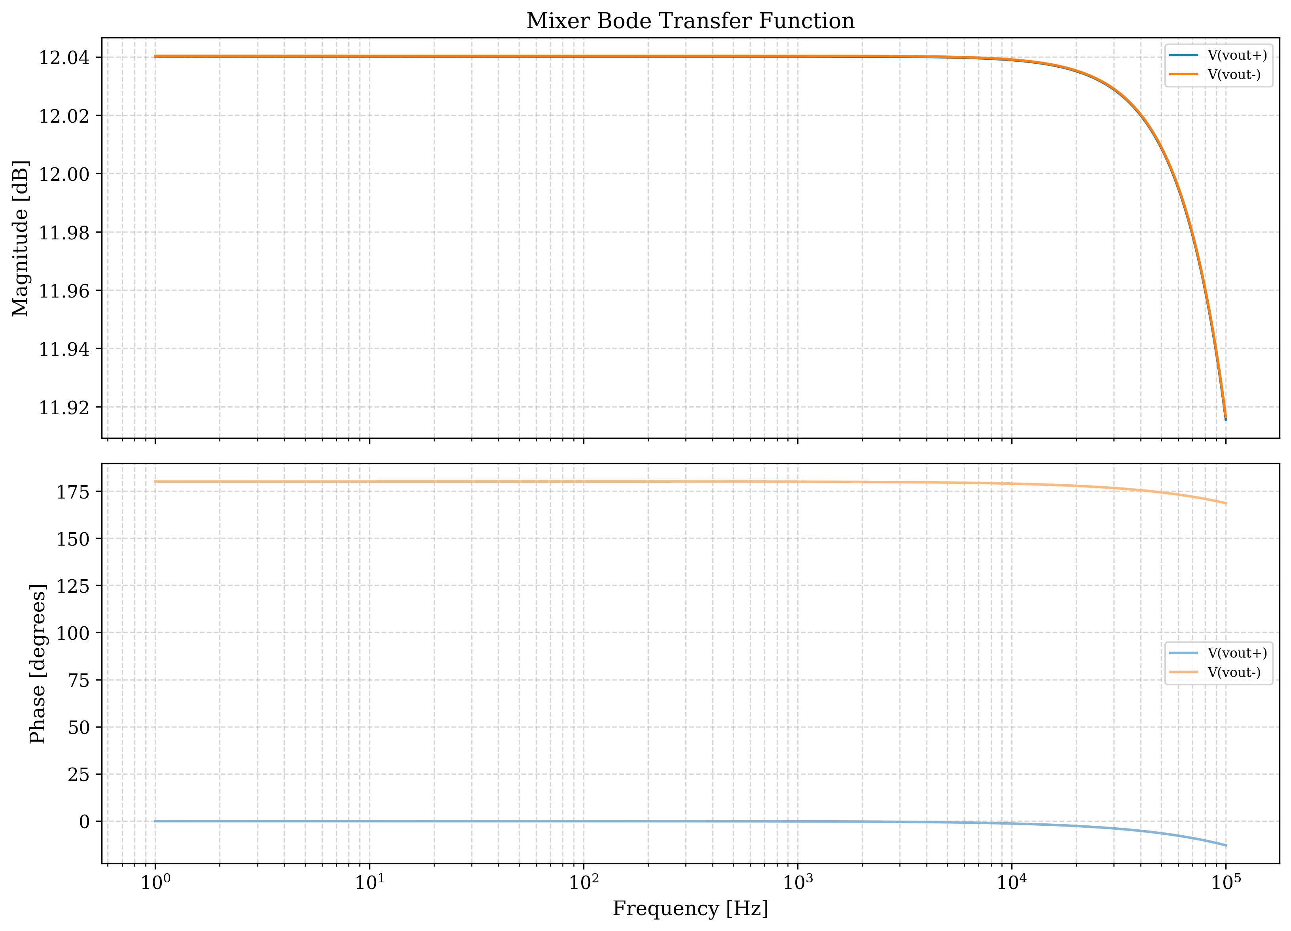
img/Mixer Bode Transfer Function.png
