dario0603/AudioAnalogMixer/AudioMixer - ModularBoards/SignalConditioning - OneChannel - Mic-Line/production/bom.csv

Designator | Footprint | Quantity | Value | LCSC Part #
C1, C2, C3 | CP_Radial_D8.0mm_P3.50mm | 3 | 100u
C10, C17, C7, C8, C9 | 0805 | 5 | 22u
C11, C12, C13, C14, C24, C25, C26, C27, C29, C30, C31, C32, C33, C34, C35, C36, C4, C5, C6 | 0805 | 19 | 10u
C15, C16 | 0603 | 2 | 1n
C18 | 0603 | 1 | 4n7
C19 | 0603 | 1 | 40n
C20, C23, C28 | 0603 | 3 | 5n
C21 | 0603 | 1 | 51n
C22 | 0603 | 1 | 20p
D1, D14, D2, D3 | LED_D3.0mm | 4 | LED
D10, D11, D4, D5, D6, D7, D8, D9 | D_SMA | 8 | 1SMA4740A
D12, D13 | SOT-23 | 2 | BZX84C5V1
J1, J3 | PinHeader_1x02_P2.54mm_Vertical | 2 | 48V_Phantom_Supply
J2, J4 | PinHeader_1x03_P2.54mm_Vertical | 2 | Dual_Power_Supply
J5 | PinHeader_1x02_P2.54mm_Vertical | 1 | Phantom_switch
J6 | Jack_XLR-6.35mm_Neutrik_NCJ6FI-H_Horizontal | 1 | XLR3_AudioJack3_Combo
J7 | PinHeader_1x03_P2.54mm_Vertical | 1 | Audio_connector
J8 | PinHeader_1x03_P2.54mm_Vertical | 1 | FX_connector
Q1 | SOT-23 | 1 | BC817
Q11 | SOT-89-3 | 1 | BCX56
Q12 | SOT-89-3 | 1 | BCX53
R1, R2 | 1206 | 2 | 2.2k
R10, R11, R20, R21, R39, R40, R41, R56, R57 | 0603 | 9 | 100
R12, R13 | 0603 | 2 | 2k2
R14, R15, R50, R60, R61 | 0603 | 5 | 47k
R16, R17, R18, R19 | 0603 | 4 | 220
R22, R23, R24, R25, R26, R27, R28, R29, R30, R31, R32, R33, R36, R37, R38, R42, R43, R44, R46, R47, R48, R49, R54 | 0603 | 23 | 10k
R3, R5, R6 | 1206 | 3 | 6.8k
R34, R35 | 0603 | 2 | 470
R4 | 1206 | 1 | 100
R45 | 0603 | 1 | 20k
R51, R58, R59 | 0603 | 3 | 3k3
R52, R53 | 0603 | 2 | 1k
R55 | 0603 | 1 | 4k5
R7, R8 | 0603 | 2 | 680
R9 | 0603 | 1 | 150
RV1 | Potentiometer_Alps_RK097_Dual_Horizontal | 1 | 10k
RV2, RV3, RV4, RV5, RV6, RV7 | Potentiometer_Alps_RK097_Single_Horizontal | 6 | 10k
TP1 | TestPoint_Pad_D1.0mm | 1 | Tone
TP2 | TestPoint_Pad_D1.0mm | 1 | FilteredWave
TP3 | TestPoint_Pad_D1.0mm | 1 | VClipp+
TP4 | TestPoint_Pad_D1.0mm | 1 | VClipp-
TP5 | TestPoint_Pad_D1.0mm | 1 | VCompIn
TP6 | TestPoint_Pad_D1.0mm | 1 | ClippingOutComp
TP7 | TestPoint_Pad_D1.0mm | 1 | Tone_out
TP8 | TestPoint_Pad_D1.0mm | 1 | FX_out
U1, U2, U3, U4, U5, U7 | SOIC-8_3.9x4.9mm_P1.27mm | 6 | NE5532
U6 | SOIC-8_3.9x4.9mm_P1.27mm | 1 | LM393
