dario0603/AudioAnalogMixer/AudioMixer - LTSpice/PowerSupplySplitter/PowerSupplySplitter.asc

C1: cap; 100µ
C2: cap; 100µ
C3: cap; 10µ
C4: cap; 10µ
Q1: npn; BCX56
Q2: pnp; BCX5316
R1: res; 47k
R2: res; 47k
V1: voltage; 15
V2: voltage; 15
Named nets: V+, V-, Virtual_gnd, 0
.param tsim=1m tstart=10m
.include NE5532.sub
.include BCX56.spice
.include BCX5316Q.spice
.tran 0 {tstart+tsim} {tstart} {tsim/100}
.model SW_d SW(Ron=0.1 Roff=1MEG Vt=0.5)
.model SW_i SW(Ron=1MEG Roff=0.1 Vt=0.5)
