dario0603/AudioAnalogMixer/AudioMixer - LTSpice/Mic-Line amplifier/AudioMixer - Mic-Line-amp.asc

B1: bv; V=if(V(XLR)==1, V(Vin), 0V)
B2: bv; V=if(V(XLR)==1, -V(Vin), 0V)
B3: bv; V=if(V(XLR)==0, 10*V(Vin), 0V)
B4: bv; V=if(V(XLR)==0, -10*V(Vin), 0V)
C1: cap; 22µ
C2: cap; 22µ
C3: cap; 22µ
C4: cap; 22µ
C5: cap; 1n
C6: cap; 22µ
C7: cap; 1n
C9: cap; 4.7n
C10: cap; 40n
R1: res; 6.8k
R2: res; 6.8k
R3: res; 680
R4: res; 2.2k
R5: res; 680
R6: res; 150
R7: res; 2.2k
R8: res; 100
R9: res; 220
R10: res; 220
R11: res; 10k
R12: res; 10k
R13: res; 47k
R14: res; {Rpot+100}
R15: res; 10k
R16: res; 10k
R17: res; 10k
R18: res; 10k
R19: res; 47k
R20: res; 100
R21: res; 220
R22: res; 220
R23: res; 10k
R24: res; 10k
R25: res; {Rpot+100}
R26: res; 10k
R27: res; 10k
R28: res; 10k
R29: res; 10k
R30: res; 10k
R31: res; 10k
R32: res; 10k
R33: res; 470
R34: res; 470
U1: opamp2; NE5532
U2: opamp2; NE5532
U3: opamp2; NE5532
U4: opamp2; NE5532
U5: opamp2; NE5532
U6: opamp2; NE5532
V1: voltage; 15
V2: voltage; 15
V3: voltage; SINE(0 {Vamp} {fin}); AC 1
V4: voltage; 48
V5: voltage; 1
Named nets: 0, V+, V-, Vin, XLR+, XLR-, Jack+, Jack-, Vph, XLR, Tone
.param Rpot=10k Vamp=30m fin=5k tstart=50m
.lib NE5532.sub
.tran 0 {tstart+10/fin} {tstart} {0.01/fin}
20dB attenuation PAD
Used to connect
XLR or Jack input
Input impedance of
the next stage
.ac dec 100 1 1MEG
