dario0603/AudioAnalogMixer/AudioMixer - LTSpice/3bEq/AudioMixer - 3bEq.asc

C1: cap; 4.7n
C2: cap; 40n
C3: cap; 5n
C4: cap; 51n
C5: cap; 20p
C6: cap; 4.7n
C7: cap; 40n
C8: cap; 5n
C9: cap; 51n
C10: cap; 20p
R1: res; 10k
R2: res; {Rh}
R3: res; 10k
R4: res; {Rm}
R5: res; 10k
R6: res; {Rl}
R7: res; 100
R8: res; 100
R9: res; 100
R10: res; 10k
R11: res; 10k
R12: res; 10k
R13: res; 20k
R14: res; 100
R15: res; 10k
R16: res; {Rh}
R17: res; 10k
R18: res; {Rm}
R19: res; 10k
R20: res; {Rl}
R21: res; 100
R22: res; 100
R23: res; 100
R24: res; 10k
R25: res; 10k
R26: res; 10k
R27: res; 20k
R28: res; 100
U1: ADTL082
U2: ADTL082
U3: ADTL082
U4: ADTL082
U5: opamp2; NE5532
U6: opamp2; NE5532
U7: opamp2; NE5532
U8: opamp2; NE5532
V1: voltage; 15
V2: voltage; 15
V3: voltage; ""; AC 1 0
Named nets: 0, V+, V-, Vin, Vh, Vm, Vl, Vh1, Vm1, Vl1, Vout1, Vout
.ac dec 100 1 100k
.param Rh=10k Rl=10k Rm=10k
.step param Rh 1k 10k 3k
.step param Rm 1k 10k 3k
.step param Rl 1k 10k 3k
3.3kHz cutoff frequency
397Hz - 3.18kHz cutoff frequency
312Hz cutoff frequency
.lib NE5532.sub
.op
.noise V(Vout) V3 dec 100 1 100MEG
3.3kHz cutoff frequency
397Hz - 3.18kHz cutoff frequency
312Hz cutoff frequency
.noise V(Vout1) V3 dec 100 1 100MEG
Adopted Solution for less output noise
