dario0603/AudioAnalogMixer/AudioMixer - LTSpice/ClippingLed/ClippingLed.asc

C1: cap; 5n
C2: cap; 5n
D1: zener; UMZ5_1N
D2: zener; UMZ5_1N
D3: diode; NSPW500BS
Q1: npn; 2N2222
R1: res; 3.3k
R2: res; 10k
R3: res; 10k
R4: res; 3.3k
R5: res; 3.3k
R7: res; 47k
U1: opamp2; LM2903B
U2: opamp2; LM2903B
V1: voltage; 15
V2: voltage; 15
V3: voltage; SINE(0 {Vamp} {fin})
Named nets: V+, V-, Vin, 0
.param Vamp=15 fin=1k
.tran 0 {10/fin} 0 {0.1/fin}
.lib LM393.lib
