dario0603/AudioAnalogMixer/AudioMixer - LTSpice/4ChannelMixer/Montecarlo/4ChannelMixer.asc

C1: cap; 20p
C2: cap; 10µ
C3: cap; 10µ
D1: diode; 1N914
D2: diode; 1N914
D3: diode; 1N914
D4: diode; 1N914
Q1: npn; BCX56
Q2: npn; BCX56
Q3: pnp; BCX5316
Q4: pnp; BCX5316
R1: res; 100
R2: res; 100
R3: res; 100
R4: res; 100
R5: res; {mc(10k,0.01)}
R6: res; {mc(10k,0.01)}
R7: res; {mc(10k,0.01)}
R8: res; {mc(10k,0.01)}
R9: res; {mc(10k,0.01)}
R10: res; 100k
R11: res; 100k
R12: res; 100
R13: res; 100k
R14: res; 100k
R15: res; {mc(10k,0.01)}
R16: res; {mc(10k,0.01)}
Rpot_H: res; {Rpot}
Rpot_L: res; {10k-Rpot}
U1: opamp2; NE5532
U2: opamp2; NE5532
U3: opamp2; NE5532
U4: opamp2; NE5532
U5: opamp2; NE5532
U6: opamp2; NE5532
U7: opamp2; NE5532
V1: voltage; 15
V2: voltage; 15
V3: voltage; SINE(0 {Vam} {f}); AC 1 0
Named nets: 0, V+, V-, Vin, Vout-, Vout+
.param Rpot=0.1 Vam=1 f=5k
.include NE5532.sub
.include BCX56.spice
.include BCX5316Q.spice
.ac dec 100 1 100k
.tran 0 {10/f} 0 {0.01/f}
.step param run 1 300 1
