dario0603/AudioAnalogMixer/AudioMixer - LTSpice/Mic-Line amplifier/Montecarlo/AudioMixer - Mic-Line-amp.asc

B1: bv; V=V(Vin)
B2: bv; V=-V(Vin)
C1: cap; 22µ
C2: cap; 22µ
C5: cap; 1n
C6: cap; 22µ
C9: cap; 4.7n
C10: cap; 40n
R1: res; 6.8k
R2: res; 6.8k
R4: res; 2.2k
R7: res; 2.2k
R8: res; 100
R9: res; 220
R10: res; 220
R11: res; {mc(10k,0.01)}
R12: res; {mc(10k,0.01)}
R14: res; {Rpot+100}
R15: res; {mc(10k,0.01)}
R16: res; {mc(10k,0.01)}
R17: res; {mc(10k,0.01)}
R18: res; {mc(10k,0.01)}
R30: res; 10k
R31: res; 10k
R32: res; 10k
R33: res; {mc(470,0.01)}
R34: res; {mc(470,0.01)}
U1: opamp2; NE5532
U2: opamp2; NE5532
U5: opamp2; NE5532
V1: voltage; 15
V2: voltage; 15
V3: voltage; SINE(0 {Vamp} {fin}); AC 1
V4: voltage; 48
Named nets: 0, V+, V-, Vin, XLR+, XLR-, Vph, Tone
.param Rpot=10k Vamp=30m fin=5k tstart=50m
.lib NE5532.sub
.tran 0 {tstart+10/fin} {tstart} {0.01/fin}
Input impedance of
the next stage
.ac dec 100 1 1MEG
.step param run 1 300 1
