dario0603/AudioAnalogMixer/AudioMixer - LTSpice/3bEq/Montecarlo/AudioMixer - 3bEq.asc

C1: cap; {wc(4.7n,0.1)}
C2: cap; {wc(40n,0.1)}
C3: cap; {wc(5n,0.1)}
C4: cap; {wc(51n,0.1)}
C5: cap; 20p
C6: cap; {mc(4.7n,0.1)}
C7: cap; {mc(40n,0.1)}
C8: cap; {mc(5n,0.1)}
C9: cap; {mc(51n,0.1)}
C10: cap; 20p
R1: res; {wc(10k,0.01)}
R2: res; {wc({Rh},0.01)}
R3: res; {wc(10k,0.01)}
R4: res; {wc({Rm},0.01)}
R5: res; {wc(10k,0.01)}
R6: res; {wc({Rl},0.01)}
R7: res; {wc(100,0.01)}
R8: res; {wc(100,0.01)}
R9: res; {wc(100,0.01)}
R10: res; {wc(10k,0.01)}
R11: res; {wc(10k,0.01)}
R12: res; {wc(10k,0.01)}
R13: res; {wc(20k,0.01)}
R14: res; {wc(100,0.01)}
R15: res; {mc(10k,0.01)}
R16: res; {mc({Rh},0.01)}
R17: res; {mc(10k,0.01)}
R18: res; {mc({Rm},0.01)}
R19: res; {mc(10k,0.01)}
R20: res; {mc({Rl},0.01)}
R21: res; {mc(100,0.01)}
R22: res; {mc(100,0.01)}
R23: res; {mc(100,0.01)}
R24: res; {mc(10k,0.01)}
R25: res; {mc(10k,0.01)}
R26: res; {mc(10k,0.01)}
R27: res; {mc(20k,0.01)}
R28: res; {mc(100,0.01)}
U1: opamp2; NE5532
U2: opamp2; NE5532
U3: opamp2; NE5532
U4: opamp2; NE5532
U5: opamp2; NE5532
U6: opamp2; NE5532
U7: opamp2; NE5532
U8: opamp2; NE5532
V1: voltage; 15
V2: voltage; 15
V3: voltage; ""; AC 1 0
Named nets: 0, V+, V-, Vin, Vh1, Vm1, Vl1, Vout1, Vh, Vm, Vl, Vout
.ac dec 100 1 100k
.param Rh=10k Rl=10k Rm=10k
.step param run 1 300 1
.lib NE5532.sub
3.3kHz cutoff frequency
397Hz - 3.18kHz cutoff frequency
312Hz cutoff frequency
Resistors tollerance 1%
Capacitors tollerance 10%
3.3kHz cutoff frequency
397Hz - 3.18kHz cutoff frequency
312Hz cutoff frequency
.func wc(nom,tol) if(flat(1)>0,nom*(1+tol),nom*(1-tol))
To perform worst case analysis, this function
allow component values to be only at the tollerance
limit
Montecarlo Simulation
Worst Case Simulation
