dario0603/AudioAnalogMixer/AudioMixer - ModularBoards/SignalConditioning - OneChannel - Mic-Line/AudioMixer.kicad_pcb

## KiCad design AudioMixer - ModularBoards/SignalConditioning - OneChannel - Mic-Line/AudioMixer.kicad_pcb (2026-11-13)

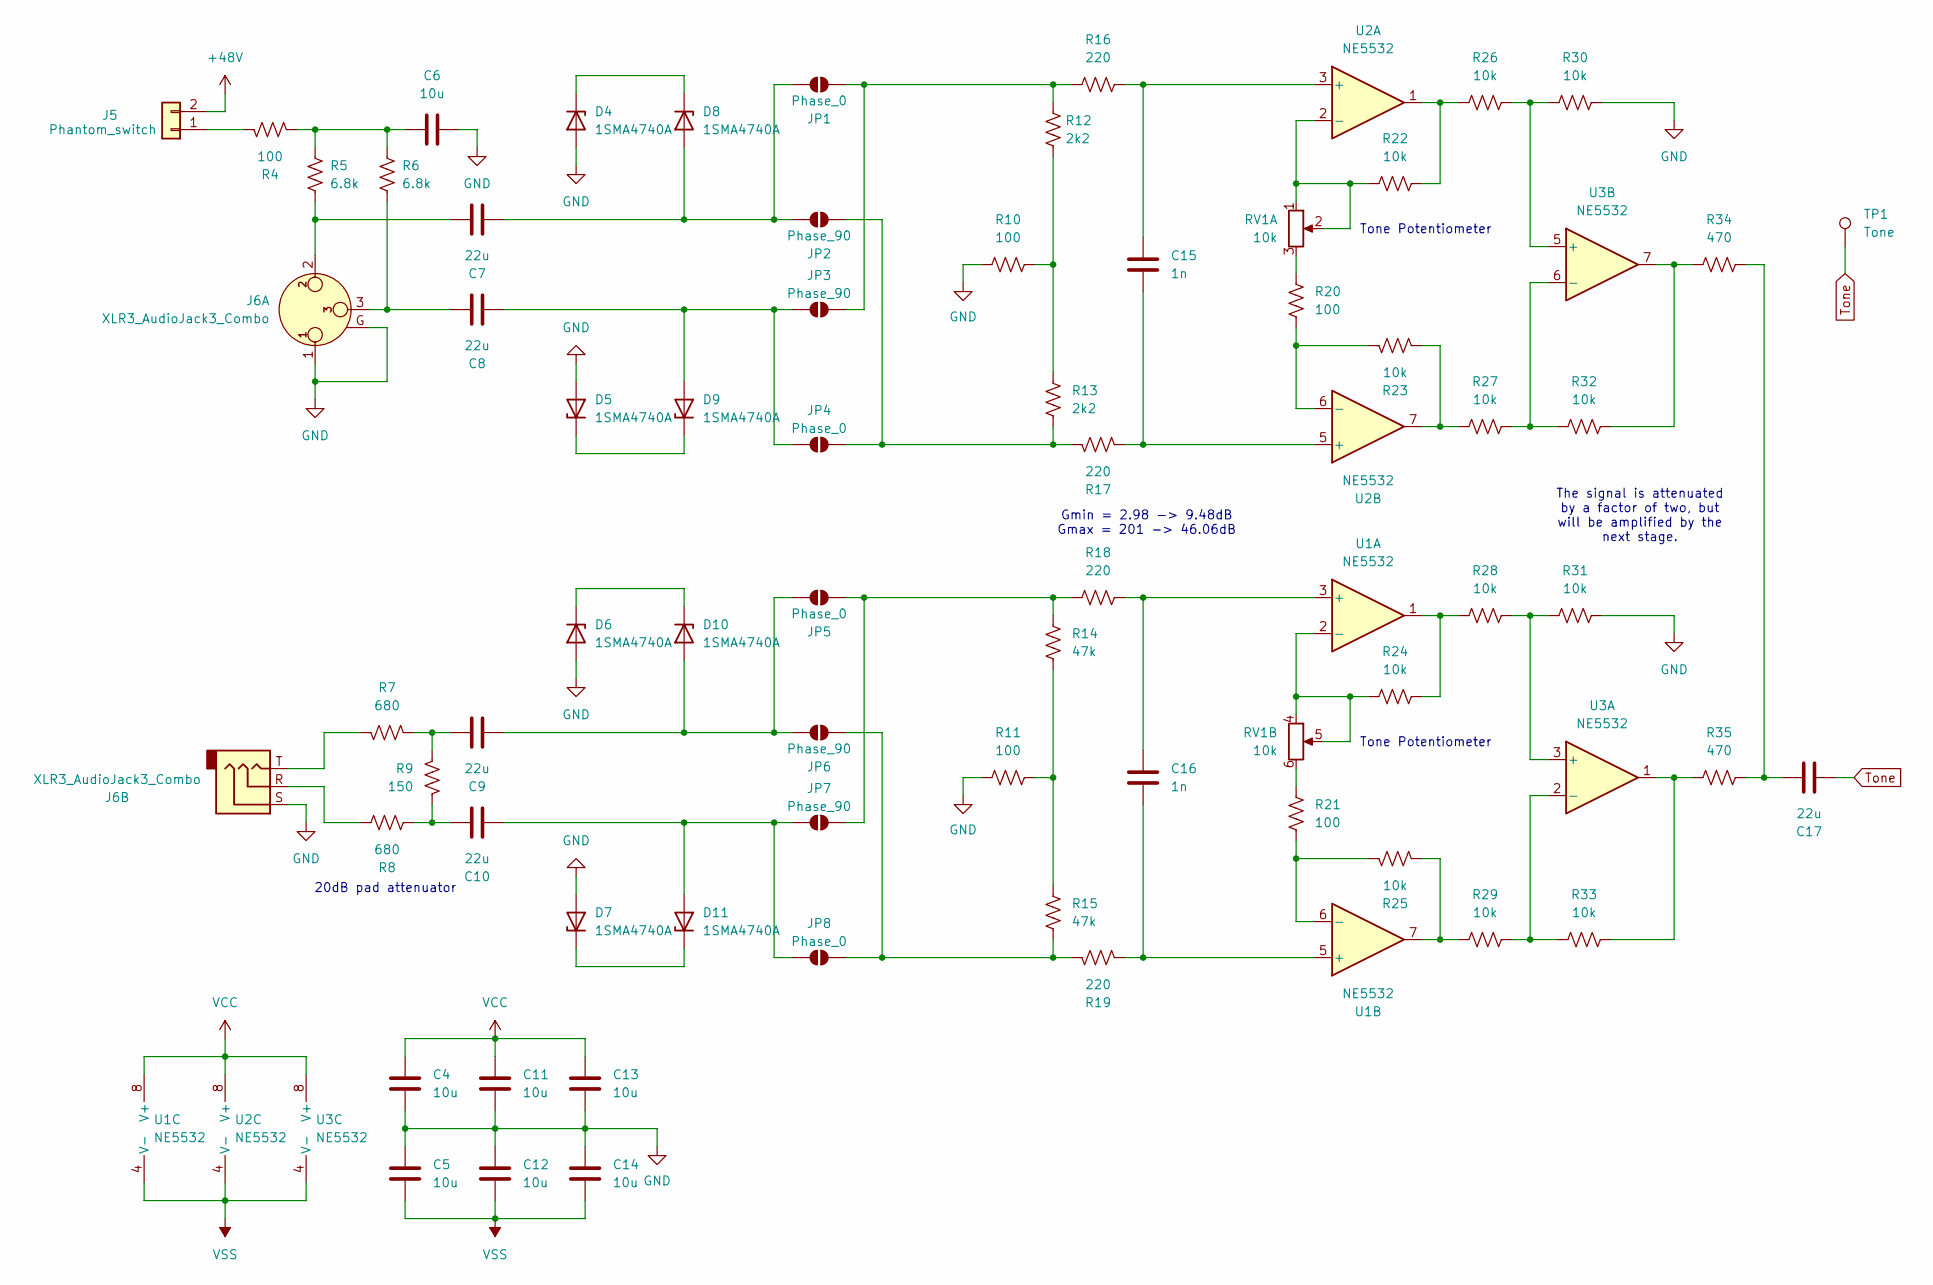
[picture p23: schematic Mic-Line_preamp.kicad_sch]

Parts:
C4, C5, C6, C11, C12, C13, C14: 10u; C_0805_2012Metric_Pad1.18x1.45mm_HandSolder
C7, C8, C9, C10, C17: 22u; C_0805_2012Metric_Pad1.18x1.45mm_HandSolder
C15, C16: 1n; C_0603_1608Metric_Pad1.08x0.95mm_HandSolder
D4, D5, D6, D7, D8, D9, D10, D11: 1SMA4740A; D_SMA
J5: Phantom_switch; PinHeader_1x02_P2.54mm_Vertical
J6: XLR3_AudioJack3_Combo; Jack_XLR-6.35mm_Neutrik_NCJ6FI-H_Horizontal
JP1, JP4, JP5, JP8: Phase_0; SolderJumper-2_P1.3mm_Open_RoundedPad1.0x1.5mm
JP2, JP3, JP6, JP7: Phase_90; SolderJumper-2_P1.3mm_Open_RoundedPad1.0x1.5mm
R4: 100; R_1206_3216Metric_Pad1.30x1.75mm_HandSolder
R5, R6: 6.8k; R_1206_3216Metric_Pad1.30x1.75mm_HandSolder
R7, R8: 680; R_0603_1608Metric_Pad0.98x0.95mm_HandSolder
R9: 150; R_0603_1608Metric_Pad0.98x0.95mm_HandSolder
R10, R11, R20, R21: 100; R_0603_1608Metric_Pad0.98x0.95mm_HandSolder
R12, R13: 2k2; R_0603_1608Metric_Pad0.98x0.95mm_HandSolder
R14, R15: 47k; R_0603_1608Metric_Pad0.98x0.95mm_HandSolder
R16, R17, R18, R19: 220; R_0603_1608Metric_Pad0.98x0.95mm_HandSolder
R22, R23, R24, R25, R26, R27, R28, R29, R30, R31, R32, R33: 10k; R_0603_1608Metric_Pad0.98x0.95mm_HandSolder
R34, R35: 470; R_0603_1608Metric_Pad0.98x0.95mm_HandSolder
RV1: 10k; Potentiometer_Alps_RK097_Dual_Horizontal
TP1: Tone; TestPoint_Pad_D1.0mm
U1, U2, U3: NE5532; SOIC-8_3.9x4.9mm_P1.27mm

Connections:
+48V: J5.2; also elsewhere on the board
GND: C4.2, C5.1, C6.1, C11.2, C12.1, C13.2, C14.1, D4.2 (A), D5.2 (A), D6.2 (A), D7.2 (A), J6.1, J6.G, J6.S, R10.1, R11.2, R30.1, R31.1; also elsewhere on the board
unnamed: C6.2, R4.1, R5.2, R6.2
unnamed: C7.1, J6.2, R5.1
unnamed: C8.1, J6.3, R6.1
unnamed: C9.1, R7.2, R9.2
unnamed: C10.1, R8.2, R9.1
unnamed: C17.1, R34.2, R35.2
unnamed: D4.1 (K), D8.1 (K)
unnamed: D5.1 (K), D9.1 (K)
unnamed: C7.2, D8.2 (A), JP1.1 (A), JP2.1 (A)
unnamed: C8.2, D9.2 (A), JP3.1 (A), JP4.1 (A)
unnamed: C9.2, D10.2 (A), JP5.1 (A), JP6.1 (A)
unnamed: D6.1 (K), D10.1 (K)
unnamed: C10.2, D11.2 (A), JP7.1 (A), JP8.1 (A)
unnamed: D7.1 (K), D11.1 (K)
unnamed: J5.1, R4.2
unnamed: J6.R, R8.1
unnamed: J6.T, R7.1
unnamed: JP1.2 (B), JP3.2 (B), R12.1, R16.2
unnamed: JP2.2 (B), JP4.2 (B), R13.2, R17.2
unnamed: JP5.2 (B), JP7.2 (B), R14.1, R18.2
unnamed: JP6.2 (B), JP8.2 (B), R15.2, R19.2
unnamed: R10.2, R12.2, R13.1
unnamed: R11.1, R14.2, R15.1
unnamed: R20.1, RV1.3
unnamed: R21.1, RV1.6
unnamed: R22.1, R26.2, U2.1
unnamed: R23.1, R27.2, U2.7
unnamed: R24.1, R28.2, U1.1
unnamed: R25.1, R29.2, U1.7
unnamed: R32.1, R34.1, U3.7
unnamed: R33.1, R35.1, U3.1
unnamed: C16.1, R18.1, U1.3 (+)
unnamed: R24.2, RV1.4, RV1.5, U1.2 (-)
unnamed: C16.2, R19.1, U1.5 (+)
unnamed: R21.2, R25.2, U1.6 (-)
unnamed: C15.1, R16.1, U2.3 (+)
unnamed: R22.2, RV1.1, RV1.2, U2.2 (-)
unnamed: C15.2, R17.1, U2.5 (+)
unnamed: R20.2, R23.2, U2.6 (-)
unnamed: R28.1, R31.2, U3.3 (+)
unnamed: R29.1, R33.2, U3.2 (-)
unnamed: R26.1, R30.2, U3.5 (+)
unnamed: R27.1, R32.2, U3.6 (-)
Tone: C17.2, TP1.1; also elsewhere on the board
VCC: C4.1, C11.1, C13.1, U1.8 (V+), U2.8 (V+), U3.8 (V+); also elsewhere on the board
VSS: C5.2, C12.2, C14.2, U1.4 (V-), U2.4 (V-), U3.4 (V-); also elsewhere on the board

Notes on the sheet:
Gmin = 2.98 -> 9.48dB Gmax = 201 -> 46.06dB
Tone Potentiometer
20dB pad attenuator
The signal is attenuated by a factor of two, but will be amplified by the next stage.

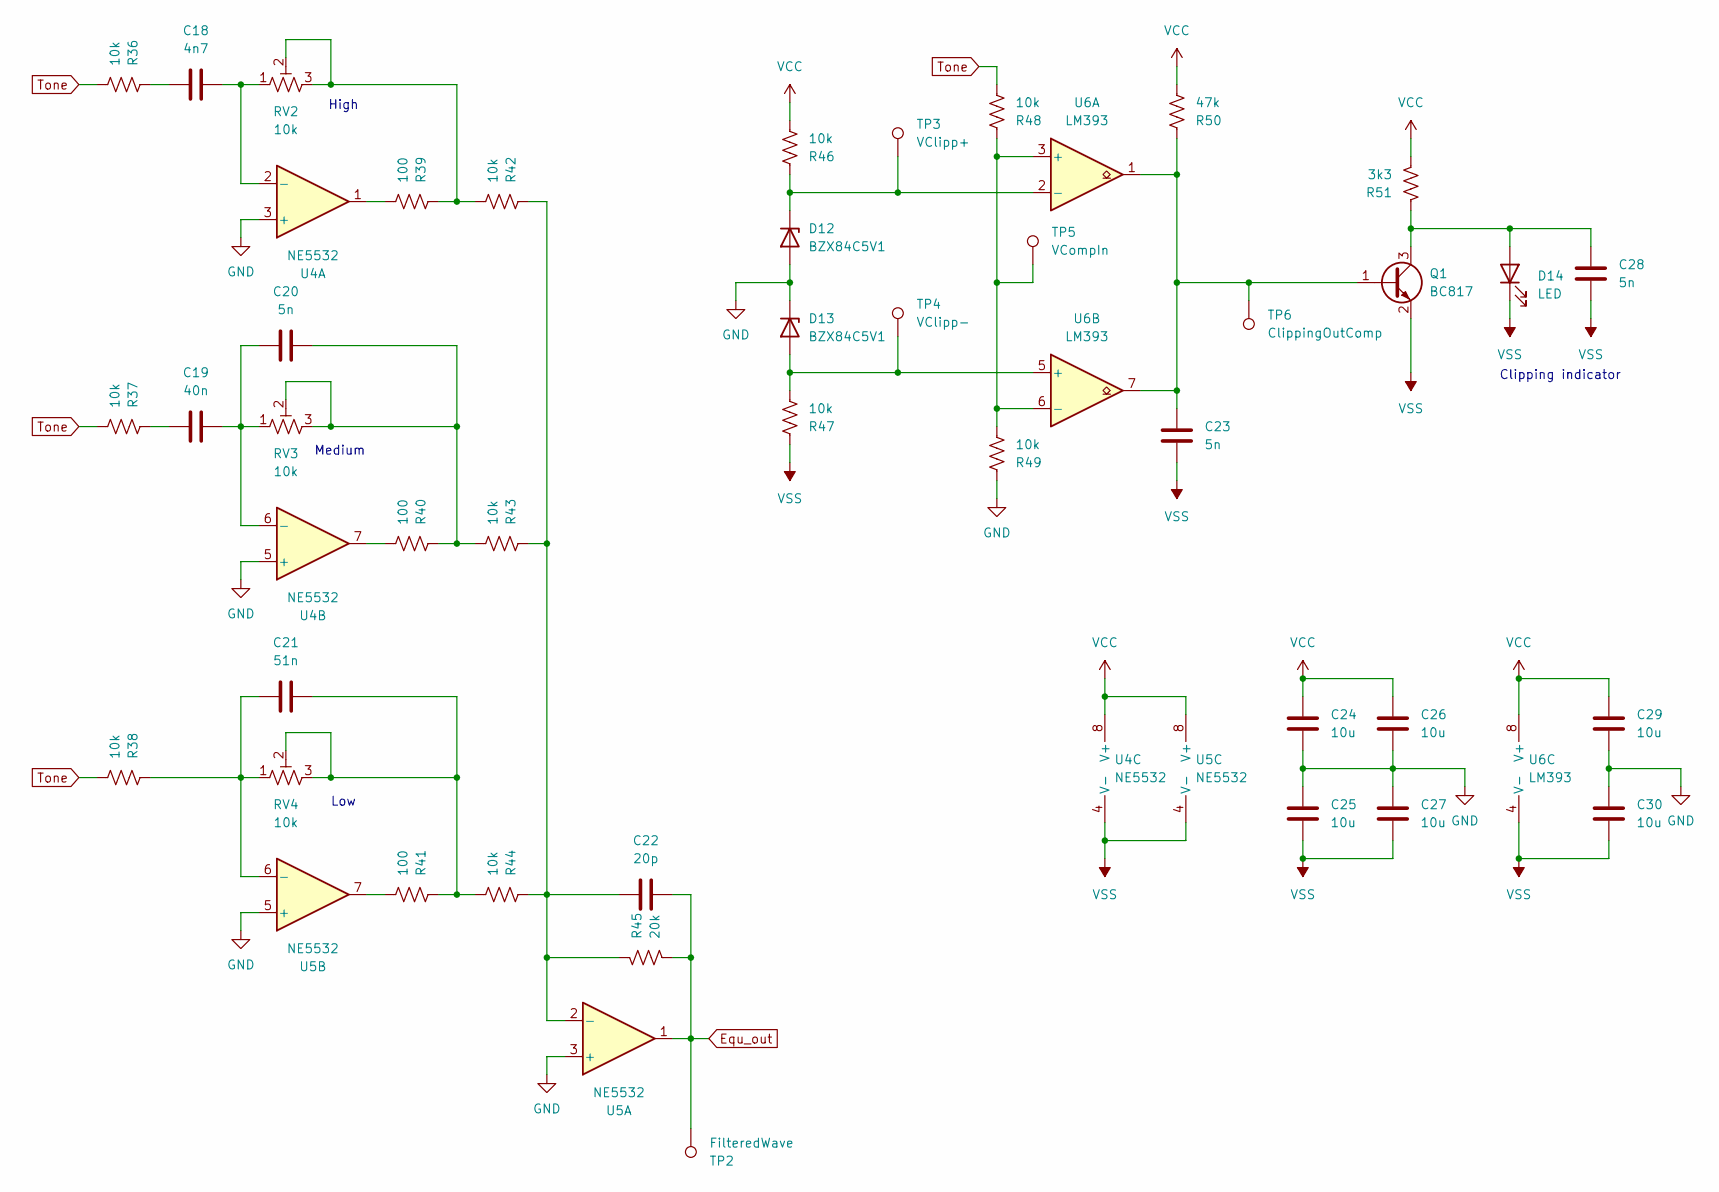
[picture p24: schematic 3_band_equalizer.kicad_sch]

Parts:
C18: 4n7; C_0603_1608Metric_Pad1.08x0.95mm_HandSolder
C19: 40n; C_0603_1608Metric_Pad1.08x0.95mm_HandSolder
C20, C23, C28: 5n; C_0603_1608Metric_Pad1.08x0.95mm_HandSolder
C21: 51n; C_0603_1608Metric_Pad1.08x0.95mm_HandSolder
C22: 20p; C_0603_1608Metric_Pad1.08x0.95mm_HandSolder
C24, C25, C26, C27, C29, C30: 10u; C_0805_2012Metric_Pad1.18x1.45mm_HandSolder
D12, D13: BZX84C5V1; SOT-23
D14: LED; LED_D3.0mm
Q1: BC817; SOT-23
R36, R37, R38, R42, R43, R44, R46, R47, R48, R49: 10k; R_0603_1608Metric_Pad0.98x0.95mm_HandSolder
R39, R40, R41: 100; R_0603_1608Metric_Pad0.98x0.95mm_HandSolder
R45: 20k; R_0603_1608Metric_Pad0.98x0.95mm_HandSolder
R50: 47k; R_0603_1608Metric_Pad0.98x0.95mm_HandSolder
R51: 3k3; R_0603_1608Metric_Pad0.98x0.95mm_HandSolder
RV2, RV3, RV4: 10k; Potentiometer_Alps_RK097_Single_Horizontal
TP2: FilteredWave; TestPoint_Pad_D1.0mm
TP3: VClipp+; TestPoint_Pad_D1.0mm
TP4: VClipp-; TestPoint_Pad_D1.0mm
TP5: VCompIn; TestPoint_Pad_D1.0mm
TP6: ClippingOutComp; TestPoint_Pad_D1.0mm
U4, U5: NE5532; SOIC-8_3.9x4.9mm_P1.27mm
U6: LM393; SOIC-8_3.9x4.9mm_P1.27mm

Connections:
Equ_out: C22.2, R45.2, TP2.1, U5.1; also elsewhere on the board
GND: C24.2, C25.1, C26.2, C27.1, C29.2, C30.1, D12.1 (A), D13.3 (K), R49.1, U4.3 (+), U4.5 (+), U5.3 (+), U5.5 (+); also elsewhere on the board
unnamed: C18.2, R36.1
unnamed: C19.2, R37.1
unnamed: C20.1, R40.1, R43.2, RV3.2, RV3.3
unnamed: C21.1, R41.1, R44.2, RV4.2, RV4.3
unnamed: D12.3 (K), R46.1, TP3.1, U6.2 (-)
unnamed: D13.1 (A), R47.2, TP4.1, U6.5 (+)
unnamed: C28.1, D14.2 (A), Q1.3 (C), R51.1
unnamed: C23.1, Q1.1 (B), R50.1, TP6.1, U6.1, U6.7
unnamed: R39.1, R42.2, RV2.2, RV2.3
unnamed: R39.2, U4.1
unnamed: R40.2, U4.7
unnamed: R41.2, U5.7
unnamed: C18.1, RV2.1, U4.2 (-)
unnamed: C19.1, C20.2, RV3.1, U4.6 (-)
unnamed: C22.1, R42.1, R43.1, R44.1, R45.1, U5.2 (-)
unnamed: C21.2, R38.1, RV4.1, U5.6 (-)
unnamed: R48.1, R49.2, TP5.1, U6.3 (+), U6.6 (-)
Tone: R36.2, R37.2, R38.2, R48.2; also elsewhere on the board
VCC: C24.1, C26.1, C29.1, R46.2, R50.2, R51.2, U4.8 (V+), U5.8 (V+), U6.8 (V+); also elsewhere on the board
VSS: C23.2, C25.2, C27.2, C28.2, C30.2, D14.1 (K), Q1.2 (E), R47.1, U4.4 (V-), U5.4 (V-), U6.4 (V-); also elsewhere on the board

Notes on the sheet:
High
Medium
Clipping indicator
Low

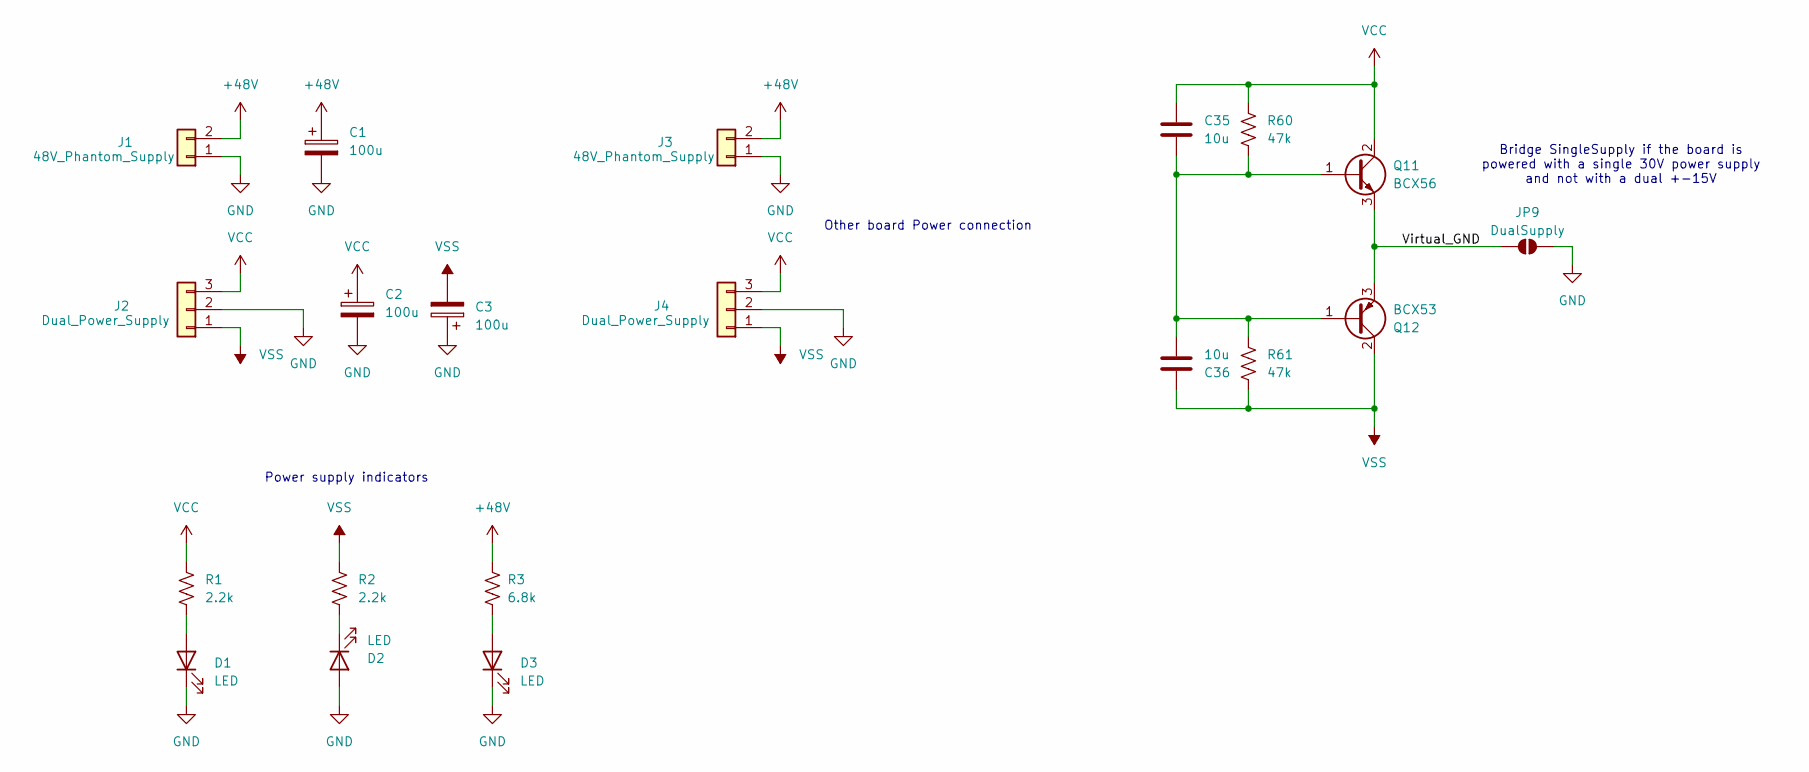
[picture p25: schematic Power_supply.kicad_sch]

Parts:
C1, C2, C3: 100u; CP_Radial_D8.0mm_P3.50mm
C35, C36: 10u; C_0805_2012Metric_Pad1.18x1.45mm_HandSolder
D1, D2, D3: LED; LED_D3.0mm
J1, J3: 48V_Phantom_Supply; PinHeader_1x02_P2.54mm_Vertical
J2, J4: Dual_Power_Supply; PinHeader_1x03_P2.54mm_Vertical
JP9: DualSupply; SolderJumper-2_P1.3mm_Open_RoundedPad1.0x1.5mm
Q11: BCX56; SOT-89-3
Q12: BCX53; SOT-89-3
R1, R2: 2.2k; R_1206_3216Metric_Pad1.30x1.75mm_HandSolder
R3: 6.8k; R_1206_3216Metric_Pad1.30x1.75mm_HandSolder
R60, R61: 47k; R_0603_1608Metric_Pad0.98x0.95mm_HandSolder

Connections:
+48V: C1.1, J1.2, J3.2, R3.2; also elsewhere on the board
/Power supply/Virtual_GND: JP9.1 (A), Q11.3 (E), Q12.3 (E)
GND: C1.2, C2.2, C3.1, D1.1 (K), D2.2 (A), D3.1 (K), J1.1, J2.2, J3.1, J4.2, JP9.2 (B); also elsewhere on the board
unnamed: D1.2 (A), R1.1
unnamed: D2.1 (K), R2.1
unnamed: D3.2 (A), R3.1
unnamed: C35.2, C36.2, Q11.1 (B), Q12.1 (B), R60.2, R61.1
VCC: C2.1, C35.1, J2.3, J4.3, Q11.2 (C), R1.2, R60.1; also elsewhere on the board
VSS: C3.2, C36.1, J2.1, J4.1, Q12.2 (C), R2.2, R61.2; also elsewhere on the board

Notes on the sheet:
Bridge SingleSupply if the board is powered with a single 30V power supply and not with a dual +-15V
Other board Power connection
Power supply indicators

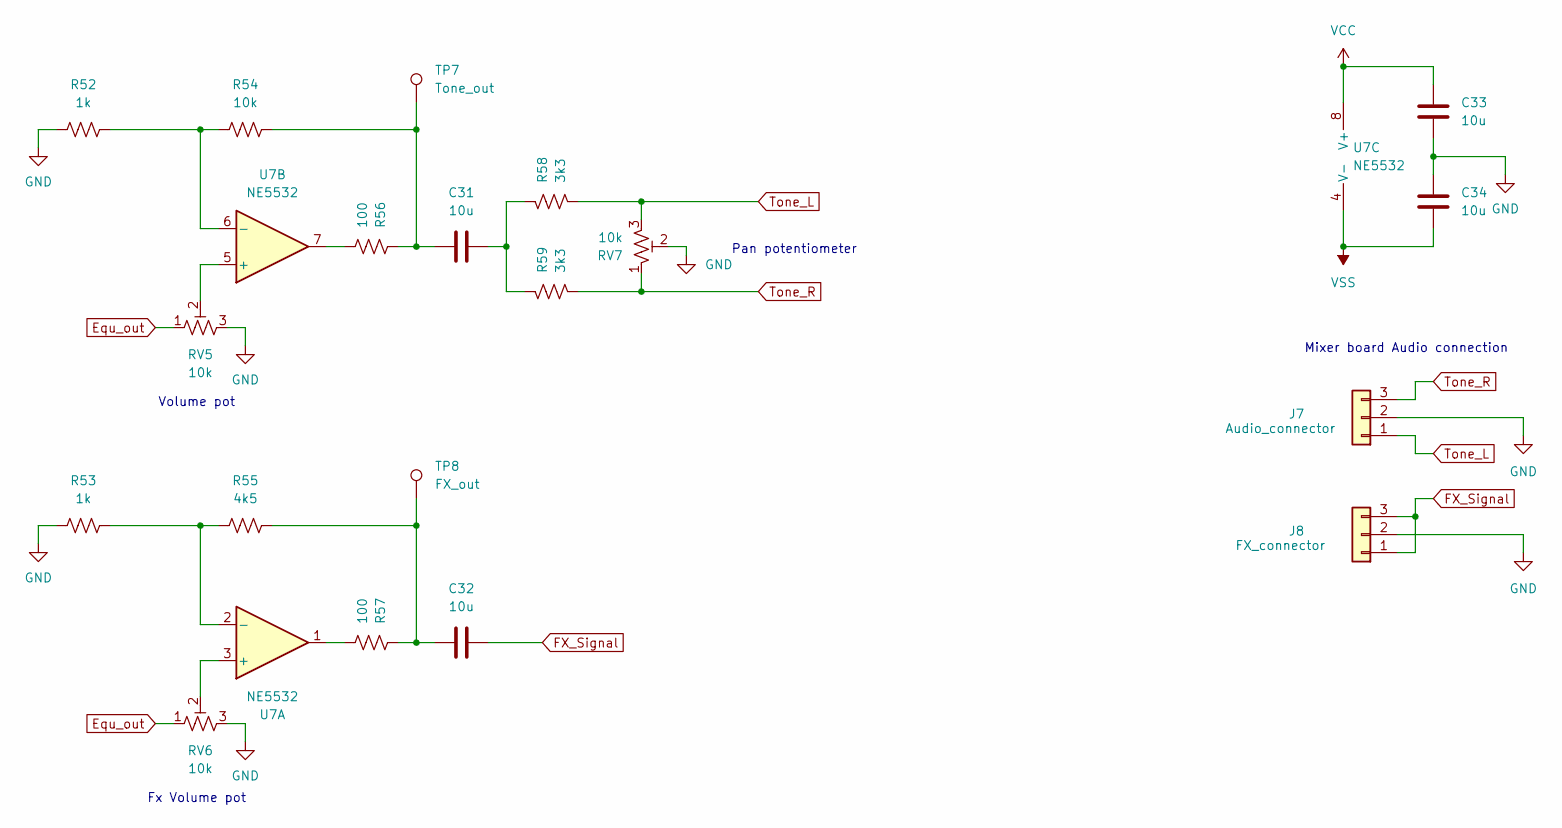
[picture p26: schematic Level_and_FXSend.kicad_sch]

Parts:
C31, C32, C33, C34: 10u; C_0805_2012Metric_Pad1.18x1.45mm_HandSolder
J7: Audio_connector; PinHeader_1x03_P2.54mm_Vertical
J8: FX_connector; PinHeader_1x03_P2.54mm_Vertical
R52, R53: 1k; R_0603_1608Metric_Pad0.98x0.95mm_HandSolder
R54: 10k; R_0603_1608Metric_Pad0.98x0.95mm_HandSolder
R55: 4k5; R_0603_1608Metric_Pad0.98x0.95mm_HandSolder
R56, R57: 100; R_0603_1608Metric_Pad0.98x0.95mm_HandSolder
R58, R59: 3k3; R_0603_1608Metric_Pad0.98x0.95mm_HandSolder
RV5, RV6, RV7: 10k; Potentiometer_Alps_RK097_Single_Horizontal
TP7: Tone_out; TestPoint_Pad_D1.0mm
TP8: FX_out; TestPoint_Pad_D1.0mm
U7: NE5532; SOIC-8_3.9x4.9mm_P1.27mm

Connections:
Equ_out: RV5.1, RV6.1; also elsewhere on the board
FX_Signal: C32.2, J8.1, J8.3
GND: C33.2, C34.1, J7.2, J8.2, R52.2, R53.2, RV5.3, RV6.3, RV7.2; also elsewhere on the board
unnamed: C31.1, R54.1, R56.1, TP7.1
unnamed: C31.2, R58.1, R59.1
unnamed: C32.1, R55.1, R57.1, TP8.1
unnamed: R56.2, U7.7
unnamed: R57.2, U7.1
unnamed: RV6.2, U7.3 (+)
unnamed: R53.1, R55.2, U7.2 (-)
unnamed: RV5.2, U7.5 (+)
unnamed: R52.1, R54.2, U7.6 (-)
Tone_L: J7.1, R58.2, RV7.3
Tone_R: J7.3, R59.2, RV7.1
VCC: C33.1, U7.8 (V+); also elsewhere on the board
VSS: C34.2, U7.4 (V-); also elsewhere on the board

Notes on the sheet:
Mixer board Audio connection
Volume pot
Pan potentiometer
Fx Volume pot

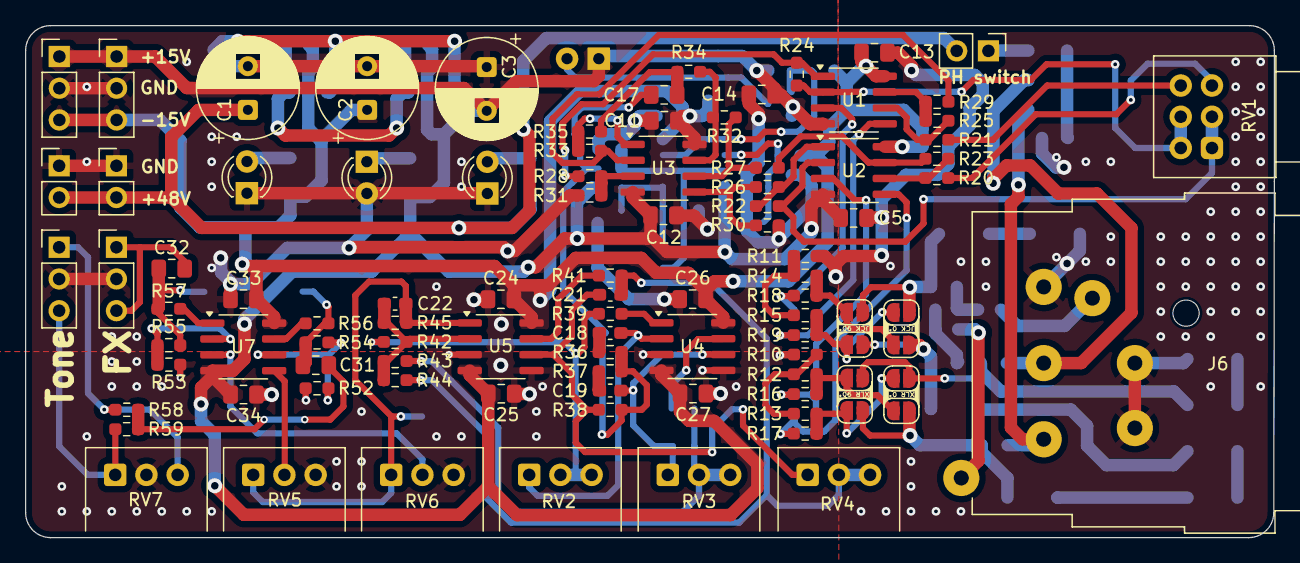
[picture p27: board AudioMixer - ModularBoards/SignalConditioning - OneChannel - Mic-Line… from above]

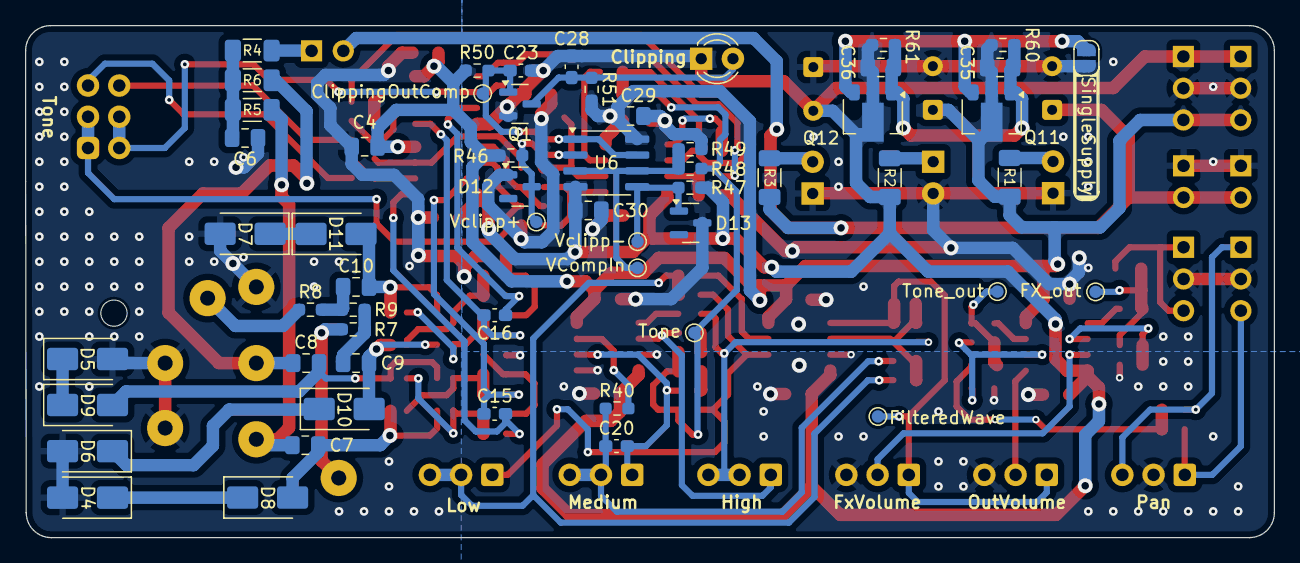
[picture p28: board AudioMixer - ModularBoards/SignalConditioning - OneChannel - Mic-Line… from below]

Board: 2 copper layers, 100.0 x 41.0 mm, 153 parts (57 on the bottom side), 83 nets.
