dario0603/AudioAnalogMixer/AudioMixer - ModularBoards/SignalConditioning - TwoChannels - R-L-Line/AudioMixer.kicad_pcb

## KiCad design AudioMixer - ModularBoards/SignalConditioning - TwoChannels - R-L-Line/AudioMixer.kicad_pcb (2026-11-10)

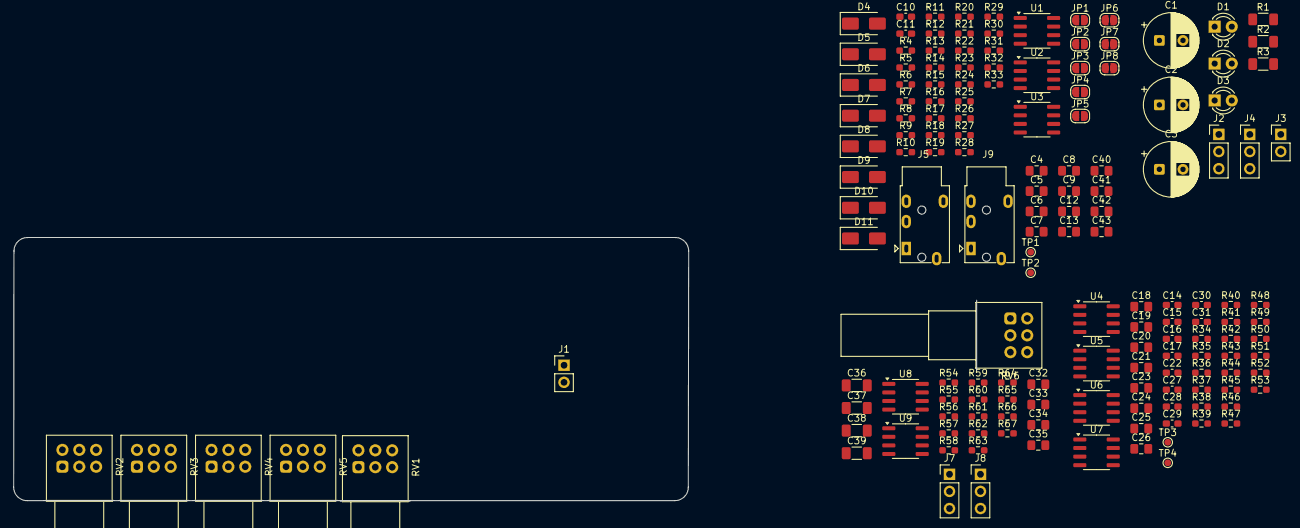
[picture p29: board AudioMixer - ModularBoards/SignalConditioning - TwoChannels - R-L-Lin… from above]

Board: 2 copper layers, 156 parts (0 on the bottom side), 97 nets, no tracks yet.

Parts:
C1, C2, C3: 100u; CP_Radial_D8.0mm_P3.50mm
C4, C5, C6, C7, C8, C9, C18, C19, C20, C21, C23, C24, C25, C26, C32, C33, C34, C35: 10u; C_0805_2012Metric_Pad1.18x1.45mm_HandSolder
C10, C11: 1n; C_0603_1608Metric_Pad1.08x0.95mm_HandSolder
C12, C13, C40, C41, C42, C43: 22u; C_0805_2012Metric_Pad1.18x1.45mm_HandSolder
C14, C27: 4n7; C_0603_1608Metric_Pad1.08x0.95mm_HandSolder
C15, C28: 40n; C_0603_1608Metric_Pad1.08x0.95mm_HandSolder
C16, C29: 5n; C_0603_1608Metric_Pad1.08x0.95mm_HandSolder
C17, C30: 51n; C_0603_1608Metric_Pad1.08x0.95mm_HandSolder
C22, C31: 20p; C_0603_1608Metric_Pad1.08x0.95mm_HandSolder
C36, C37, C38, C39: 10u; C_1206_3216Metric_Pad1.33x1.80mm_HandSolder
D1, D2, D3: LED; LED_D3.0mm
D4, D5, D6, D7, D8, D9, D10, D11: 1SMA4740A; D_SMA
J1, J3: 48V_Phantom_Supply; PinHeader_1x02_P2.54mm_Vertical
J2, J4: Dual_Power_Supply; PinHeader_1x03_P2.54mm_Vertical
J5: Left_in; Jack_3.5mm_PJ320E_Horizontal
J7: Audio_connector; PinHeader_1x03_P2.54mm_Vertical
J8: FX_connector; PinHeader_1x03_P2.54mm_Vertical
J9: Right_in; Jack_3.5mm_PJ320E_Horizontal
JP1, JP4, JP5, JP8: Phase_0; SolderJumper-2_P1.3mm_Open_RoundedPad1.0x1.5mm
JP2, JP3, JP6, JP7: Phase_90; SolderJumper-2_P1.3mm_Open_RoundedPad1.0x1.5mm
R1, R2: 2.2k; R_1206_3216Metric_Pad1.30x1.75mm_HandSolder
R3: 6.8k; R_1206_3216Metric_Pad1.30x1.75mm_HandSolder
R4, R5: 100k; R_0603_1608Metric_Pad0.98x0.95mm_HandSolder
R6, R7, R8, R9: 2k2; R_0603_1608Metric_Pad0.98x0.95mm_HandSolder
R10, R11, R12, R13: 220; R_0603_1608Metric_Pad0.98x0.95mm_HandSolder
R14, R15, R16, R17, R18, R19, R20, R21, R22, R23, R24, R25, R26, R27, R28, R29, R30, R31, R32, R33, R34, R35, R36, R40, R41, R42, R44, R45, R46, R50, R51, R52, R56, R57, R62, R63, R66, R67: 10k; R_0603_1608Metric_Pad0.98x0.95mm_HandSolder
R37, R38, R39, R47, R48, R49, R58, R59, R64, R65: 100; R_0603_1608Metric_Pad0.98x0.95mm_HandSolder
R43, R53: 20k; R_0603_1608Metric_Pad0.98x0.95mm_HandSolder
R54, R55, R60, R61: 1k; R_0603_1608Metric_Pad0.98x0.95mm_HandSolder
RV1, RV2, RV3, RV4, RV5, RV6: 10k; Potentiometer_Alps_RK097_Dual_Horizontal
TP1, TP2: Tone; TestPoint_Pad_D1.0mm
TP3, TP4: FilteredWave; TestPoint_Pad_D1.0mm
U1, U2, U3, U4, U5, U6, U7, U8, U9: NE5532; SOIC-8_3.9x4.9mm_P1.27mm

Connections:
+48V: C1.1, J1.2, J3.2, R3.2
Eq_out_L: C31.2, R53.2, RV4.4, TP4.1, U7.1, U9.3 (+)
Eq_out_R: C22.2, R43.2, RV4.1, TP3.1, U5.1, U9.5 (+)
FX_L: J8.1, RV6.5
FX_R: J8.3, RV6.2
GND: C1.2, C2.2, C3.1, C4.2, C5.1, C6.2, C7.1, C8.2, C9.1, C18.2, C19.1, C20.2, C21.1, C23.2, C24.1, C25.2, C26.1, C32.2, C33.1, C34.2, C35.1, D1.1 (K), D2.2 (A), D3.1 (K), D4.2 (A), D5.2 (A), D6.2 (A), D7.2 (A), J1.1, J2.2, J3.1, J4.2, J5.S, J7.2, J8.2, J9.S, R4.2, R5.2, R30.1, R31.1, R54.2, R55.2, R60.2, R61.2, RV4.3, RV4.6, RV5.3, RV5.4, RV6.3, RV6.6, U4.3 (+), U4.5 (+), U5.3 (+), U5.5 (+), U6.3 (+), U6.5 (+), U7.3 (+), U7.5 (+)
unnamed: C12.1, R32.1, U3.7
unnamed: C13.1, R33.1, U3.1
unnamed: C14.2, R34.1
unnamed: C15.2, R35.1
unnamed: C16.1, R38.1, R41.2, RV2.2, RV2.3
unnamed: C17.1, R39.1, R42.2, RV3.2, RV3.3
unnamed: C27.2, R44.1
unnamed: C28.2, R45.1
unnamed: C29.1, R48.1, R51.2, RV2.5, RV2.6
unnamed: C30.1, R49.1, R52.2, RV3.5, RV3.6
unnamed: C36.1, R56.1, R58.1
unnamed: C36.2, RV5.1
unnamed: C37.1, R57.1, R59.1
unnamed: C37.2, RV5.6
unnamed: C38.1, R62.1, R64.1
unnamed: C38.2, R66.2
unnamed: C39.1, R63.1, R65.1
unnamed: C39.2, R67.2
unnamed: C40.1, J9.T
unnamed: C42.1, J5.T
unnamed: D1.2 (A), R1.1
unnamed: D2.1 (K), R2.1
unnamed: D3.2 (A), R3.1
unnamed: D4.1 (K), D8.1 (K)
unnamed: D5.1 (K), D9.1 (K)
unnamed: C40.2, D8.2 (A), JP1.1 (A), JP2.1 (A)
unnamed: C41.2, D9.2 (A), JP3.1 (A), JP4.1 (A)
unnamed: C42.2, D10.2 (A), JP5.1 (A), JP6.1 (A)
unnamed: D6.1 (K), D10.1 (K)
unnamed: C43.2, D11.2 (A), JP7.1 (A), JP8.1 (A)
unnamed: D7.1 (K), D11.1 (K)
unnamed: JP1.2 (B), JP3.2 (B), R6.1, R10.2
unnamed: JP2.2 (B), JP4.2 (B), R7.2, R11.2
unnamed: JP5.2 (B), JP7.2 (B), R8.1, R12.2
unnamed: JP6.2 (B), JP8.2 (B), R9.2, R13.2
unnamed: R4.1, R6.2, R7.1
unnamed: R5.1, R8.2, R9.1
unnamed: R14.2, R15.1
unnamed: R16.2, R17.1
unnamed: R18.1, R22.2, U2.1
unnamed: R19.1, R23.2, U2.7
unnamed: R20.1, R24.2, U1.1
unnamed: R21.1, R25.2, U1.7
unnamed: R22.1, R26.2
unnamed: R23.1, R27.2
unnamed: R24.1, R28.2
unnamed: R25.1, R29.2
unnamed: R37.1, R40.2, RV1.2, RV1.3
unnamed: R37.2, U4.1
unnamed: R38.2, U4.7
unnamed: R39.2, U5.7
unnamed: R47.1, R50.2, RV1.5, RV1.6
unnamed: R47.2, U6.1
unnamed: R48.2, U6.7
unnamed: R49.2, U7.7
unnamed: R58.2, U8.7
unnamed: R59.2, U8.1
unnamed: R64.2, U9.7
unnamed: R65.2, U9.1
unnamed: R66.1, RV6.1
unnamed: R67.1, RV6.4
unnamed: C11.1, R12.1, U1.3 (+)
unnamed: R16.1, R20.2, U1.2 (-)
unnamed: C11.2, R13.1, U1.5 (+)
unnamed: R17.2, R21.2, U1.6 (-)
unnamed: C10.1, R10.1, U2.3 (+)
unnamed: R14.1, R18.2, U2.2 (-)
unnamed: C10.2, R11.1, U2.5 (+)
unnamed: R15.2, R19.2, U2.6 (-)
unnamed: R28.1, R31.2, U3.3 (+)
unnamed: R29.1, R33.2, U3.2 (-)
unnamed: R26.1, R30.2, U3.5 (+)
unnamed: R27.1, R32.2, U3.6 (-)
unnamed: C14.1, RV1.1, U4.2 (-)
unnamed: C15.1, C16.2, RV2.1, U4.6 (-)
unnamed: C22.1, R40.1, R41.1, R42.1, R43.1, U5.2 (-)
unnamed: C17.2, R36.1, RV3.1, U5.6 (-)
unnamed: C27.1, RV1.4, U6.2 (-)
unnamed: C28.1, C29.2, RV2.4, U6.6 (-)
unnamed: C31.1, R50.1, R51.1, R52.1, R53.1, U7.2 (-)
unnamed: C30.2, R46.1, RV3.4, U7.6 (-)
unnamed: RV4.5, U8.3 (+)
unnamed: R55.1, R57.2, U8.2 (-)
unnamed: RV4.2, U8.5 (+)
unnamed: R54.1, R56.2, U8.6 (-)
unnamed: R61.1, R63.2, U9.2 (-)
unnamed: R60.1, R62.2, U9.6 (-)
Tone_L: C13.2, J7.1, R44.2, R45.2, R46.2, RV5.5, TP2.1
Tone_R: C12.2, J7.3, R34.2, R35.2, R36.2, RV5.2, TP1.1
VCC: C2.1, C4.1, C6.1, C8.1, C18.1, C20.1, C23.1, C25.1, C32.1, C34.1, J2.3, J4.3, R1.2, U1.8 (V+), U2.8 (V+), U3.8 (V+), U4.8 (V+), U5.8 (V+), U6.8 (V+), U7.8 (V+), U8.8 (V+), U9.8 (V+)
VSS: C3.2, C5.2, C7.2, C9.2, C19.2, C21.2, C24.2, C26.2, C33.2, C35.2, J2.1, J4.1, R2.2, U1.4 (V-), U2.4 (V-), U3.4 (V-), U4.4 (V-), U5.4 (V-), U6.4 (V-), U7.4 (V-), U8.4 (V-), U9.4 (V-)
