dario0603/AudioAnalogMixer/AudioMixer - ModularBoards/4ChannelMixerBoard/Mixer_circuit.kicad_pcb

## KiCad design AudioMixer - ModularBoards/4ChannelMixerBoard/Mixer_circuit.kicad_pcb (2026-11-10)

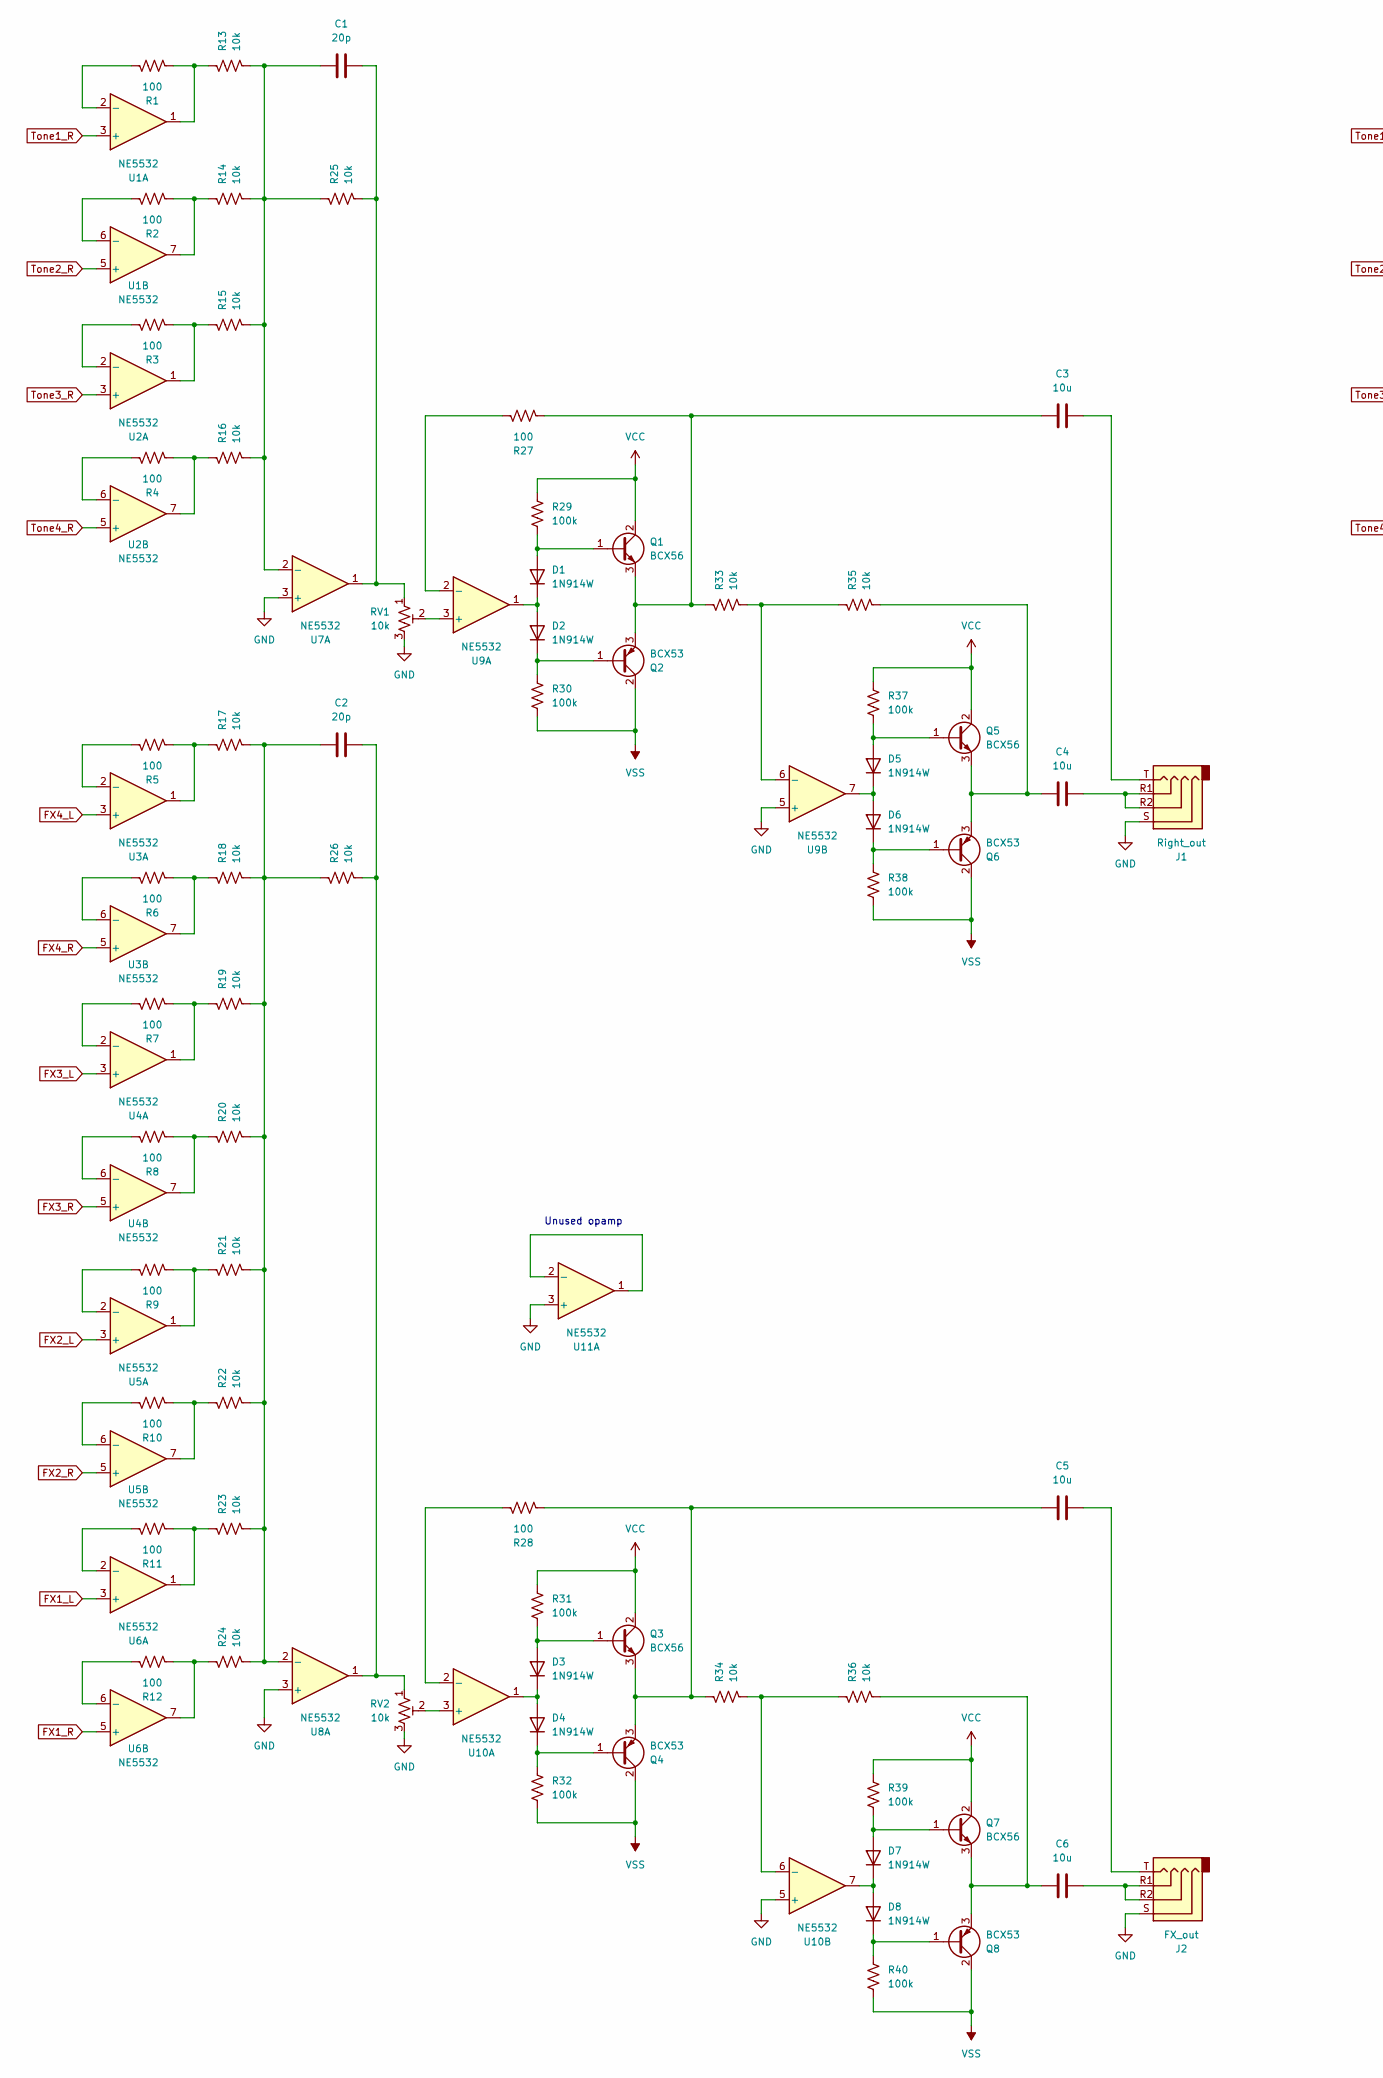
[picture p30: schematic Mixer_circuit.kicad_sch, part in row 1, column 1]

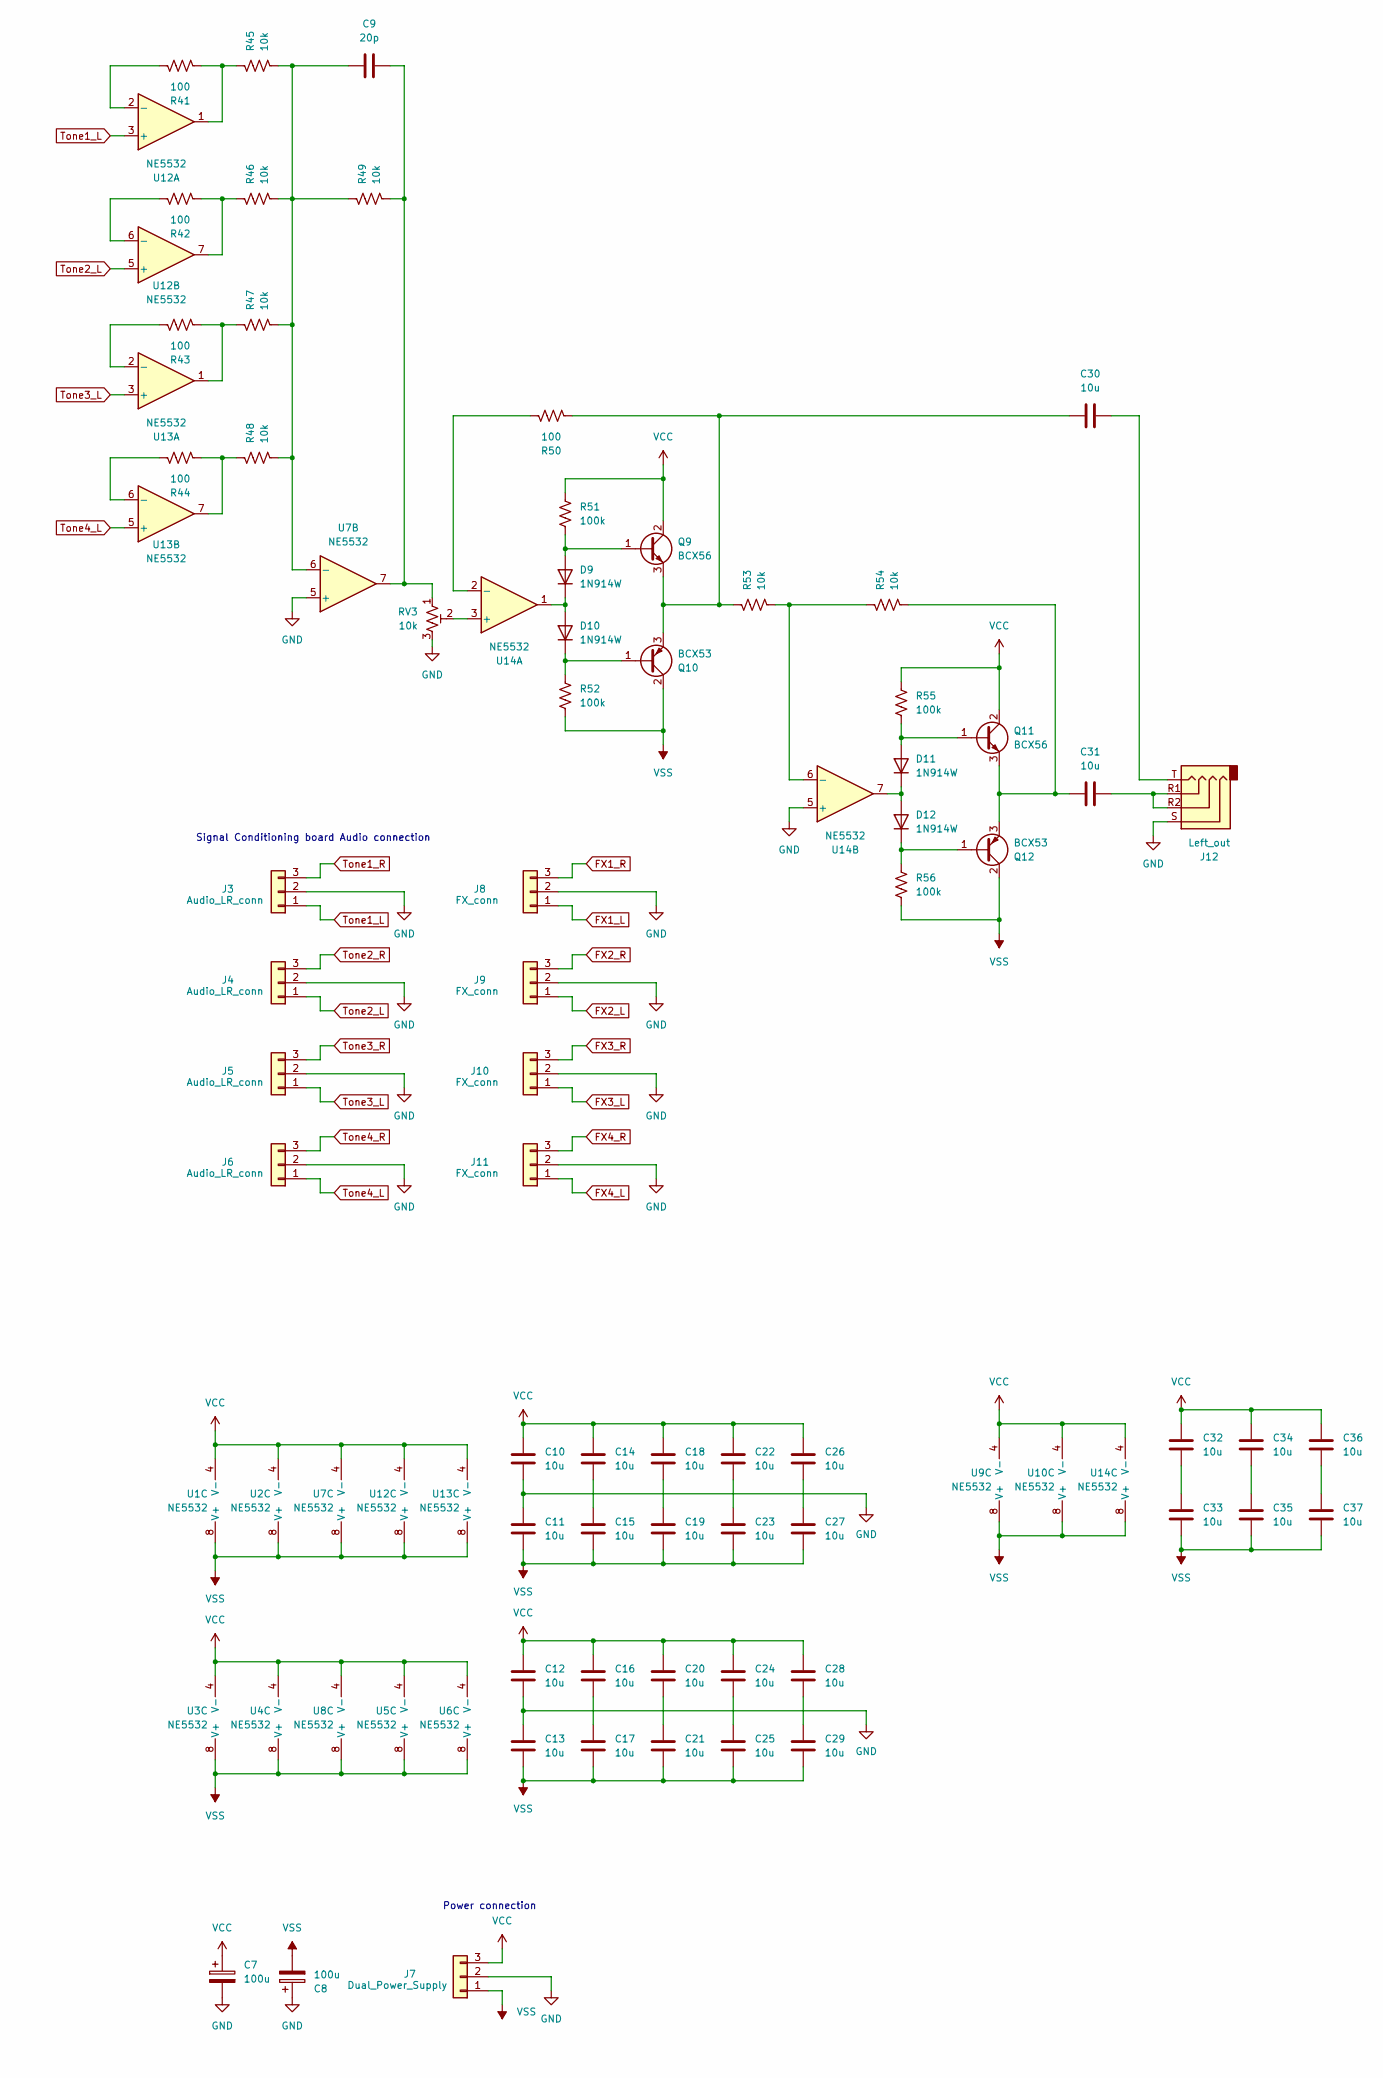
[picture p31: schematic Mixer_circuit.kicad_sch, part in row 1, column 2]

Parts:
C1, C2, C9: 20p; C_0603_1608Metric_Pad1.08x0.95mm_HandSolder
C3, C4, C5, C6, C10, C11, C12, C13, C14, C15, C16, C17, C18, C19, C20, C21, C22, C23, C24, C25, C26, C27, C28, C29, C30, C31, C32, C33, C34, C35, C36, C37: 10u; C_1206_3216Metric_Pad1.33x1.80mm_HandSolder
C7, C8: 100u; CP_Elec_10x10.5
D1, D2, D3, D4, D5, D6, D7, D8, D9, D10, D11, D12: 1N914W; D_SOD-123
J1: Right_out; Jack_3.5mm_PJ320E_Horizontal
J2: FX_out; Jack_3.5mm_PJ320E_Horizontal
J3, J4, J5, J6: Audio_LR_conn; PinHeader_1x03_P2.54mm_Vertical
J7: Dual_Power_Supply; PinHeader_1x03_P2.54mm_Vertical
J8, J9, J10, J11: FX_conn; PinHeader_1x03_P2.54mm_Vertical
J12: Left_out; Jack_3.5mm_PJ320E_Horizontal
Q1, Q3, Q5, Q7, Q9, Q11: BCX56; SOT-89-3
Q2, Q4, Q6, Q8, Q10, Q12: BCX53; SOT-89-3
R1, R2, R3, R4, R5, R6, R7, R8, R9, R10, R11, R12, R27, R28, R41, R42, R43, R44, R50: 100; R_0603_1608Metric_Pad0.98x0.95mm_HandSolder
R13, R14, R15, R16, R17, R18, R19, R20, R21, R22, R23, R24, R25, R26, R33, R34, R35, R36, R45, R46, R47, R48, R49, R53, R54: 10k; R_0603_1608Metric_Pad0.98x0.95mm_HandSolder
R29, R30, R31, R32, R37, R38, R39, R40, R51, R52, R55, R56: 100k; R_0603_1608Metric_Pad0.98x0.95mm_HandSolder
RV1, RV2, RV3: 10k; Potentiometer_Alps_RK097_Single_Horizontal
U1, U2, U3, U4, U5, U6, U7, U8, U9, U10, U11, U12, U13, U14: NE5532; SOIC-8_3.9x4.9mm_P1.27mm

Connections:
FX1_L: J8.1, U6.3 (+)
FX1_R: J8.3, U6.5 (+)
FX2_L: J9.1, U5.3 (+)
FX2_R: J9.3, U5.5 (+)
FX3_L: J10.1, U4.3 (+)
FX3_R: J10.3, U4.5 (+)
FX4_L: J11.1, U3.3 (+)
FX4_R: J11.3, U3.5 (+)
GND: C7.2, C8.1, C10.1, C11.2, C12.1, C13.2, J1.S, J2.S, J3.2, J4.2, J5.2, J6.2, J7.2, J8.2, J9.2, J10.2, J11.2, J12.S, RV1.3, RV2.3, RV3.3, U7.3 (+), U7.5 (+), U8.3 (+), U9.5 (+), U10.5 (+), U11.3 (+), U14.5 (+)
unnamed: C1.2, R25.2, RV1.1, U7.1
unnamed: C2.2, R26.2, RV2.1, U8.1
unnamed: C3.2, J1.T
unnamed: C4.2, J1.R1, J1.R2
unnamed: C5.2, J2.T
unnamed: C6.2, J2.R1, J2.R2
unnamed: C9.2, R49.2, RV3.1, U7.7
unnamed: C14.1, C15.2
unnamed: C16.1, C17.2
unnamed: C18.1, C19.2
unnamed: C20.1, C21.2
unnamed: C22.1, C23.2
unnamed: C24.1, C25.2
unnamed: C26.1, C27.2
unnamed: C28.1, C29.2
unnamed: C30.2, J12.T
unnamed: C31.2, J12.R1, J12.R2
unnamed: C32.1, C33.2
unnamed: C34.1, C35.2
unnamed: C36.1, C37.2
unnamed: D1.2 (A), Q1.1 (B), R29.2
unnamed: D1.1 (K), D2.2 (A), U9.1
unnamed: D2.1 (K), Q2.1 (B), R30.1
unnamed: D3.2 (A), Q3.1 (B), R31.2
unnamed: D3.1 (K), D4.2 (A), U10.1
unnamed: D4.1 (K), Q4.1 (B), R32.1
unnamed: D5.2 (A), Q5.1 (B), R37.2
unnamed: D5.1 (K), D6.2 (A), U9.7
unnamed: D6.1 (K), Q6.1 (B), R38.1
unnamed: D7.2 (A), Q7.1 (B), R39.2
unnamed: D7.1 (K), D8.2 (A), U10.7
unnamed: D8.1 (K), Q8.1 (B), R40.1
unnamed: D9.2 (A), Q9.1 (B), R51.2
unnamed: D9.1 (K), D10.2 (A), U14.1
unnamed: D10.1 (K), Q10.1 (B), R52.1
unnamed: D11.2 (A), Q11.1 (B), R55.2
unnamed: D11.1 (K), D12.2 (A), U14.7
unnamed: D12.1 (K), Q12.1 (B), R56.1
unnamed: C3.1, Q1.3 (E), Q2.3 (E), R27.2, R33.1
unnamed: C5.1, Q3.3 (E), Q4.3 (E), R28.2, R34.1
unnamed: C4.1, Q5.3 (E), Q6.3 (E), R35.2
unnamed: C6.1, Q7.3 (E), Q8.3 (E), R36.2
unnamed: C30.1, Q9.3 (E), Q10.3 (E), R50.2, R53.1
unnamed: C31.1, Q11.3 (E), Q12.3 (E), R54.2
unnamed: R1.2, R13.1, U1.1
unnamed: R10.2, R22.1, U5.7
unnamed: R11.2, R23.1, U6.1
unnamed: R12.2, R24.1, U6.7
unnamed: R2.2, R14.1, U1.7
unnamed: R3.2, R15.1, U2.1
unnamed: R4.2, R16.1, U2.7
unnamed: R5.2, R17.1, U3.1
unnamed: R6.2, R18.1, U3.7
unnamed: R7.2, R19.1, U4.1
unnamed: R8.2, R20.1, U4.7
unnamed: R9.2, R21.1, U5.1
unnamed: R41.2, R45.1, U12.1
unnamed: R42.2, R46.1, U12.7
unnamed: R43.2, R47.1, U13.1
unnamed: R44.2, R48.1, U13.7
unnamed: R1.1, U1.2 (-)
unnamed: R2.1, U1.6 (-)
unnamed: R3.1, U2.2 (-)
unnamed: R4.1, U2.6 (-)
unnamed: R5.1, U3.2 (-)
unnamed: R6.1, U3.6 (-)
unnamed: R7.1, U4.2 (-)
unnamed: R8.1, U4.6 (-)
unnamed: R9.1, U5.2 (-)
unnamed: R10.1, U5.6 (-)
unnamed: R11.1, U6.2 (-)
unnamed: R12.1, U6.6 (-)
unnamed: C1.1, R13.2, R14.2, R15.2, R16.2, R25.1, U7.2 (-)
unnamed: C9.1, R45.2, R46.2, R47.2, R48.2, R49.1, U7.6 (-)
unnamed: C2.1, R17.2, R18.2, R19.2, R20.2, R21.2, R22.2, R23.2, R24.2, R26.1, U8.2 (-)
unnamed: RV1.2, U9.3 (+)
unnamed: R27.1, U9.2 (-)
unnamed: R33.2, R35.1, U9.6 (-)
unnamed: RV2.2, U10.3 (+)
unnamed: R28.1, U10.2 (-)
unnamed: R34.2, R36.1, U10.6 (-)
unnamed: U11.1, U11.2 (-)
unnamed: R41.1, U12.2 (-)
unnamed: R42.1, U12.6 (-)
unnamed: R43.1, U13.2 (-)
unnamed: R44.1, U13.6 (-)
unnamed: RV3.2, U14.3 (+)
unnamed: R50.1, U14.2 (-)
unnamed: R53.2, R54.1, U14.6 (-)
Tone1_L: J3.1, U12.3 (+)
Tone1_R: J3.3, U1.3 (+)
Tone2_L: J4.1, U12.5 (+)
Tone2_R: J4.3, U1.5 (+)
Tone3_L: J5.1, U13.3 (+)
Tone3_R: J5.3, U2.3 (+)
Tone4_L: J6.1, U13.5 (+)
Tone4_R: J6.3, U2.5 (+)
VCC: C7.1, C10.2, C12.2, C14.2, C16.2, C18.2, C20.2, C22.2, C24.2, C26.2, C28.2, C32.2, C34.2, C36.2, J7.3, Q1.2 (C), Q3.2 (C), Q5.2 (C), Q7.2 (C), Q9.2 (C), Q11.2 (C), R29.1, R31.1, R37.1, R39.1, R51.1, R55.1, U1.4 (V-), U2.4 (V-), U3.4 (V-), U4.4 (V-), U5.4 (V-), U6.4 (V-), U7.4 (V-), U8.4 (V-), U9.4 (V-), U10.4 (V-), U12.4 (V-), U13.4 (V-), U14.4 (V-)
VSS: C8.2, C11.1, C13.1, C15.1, C17.1, C19.1, C21.1, C23.1, C25.1, C27.1, C29.1, C33.1, C35.1, C37.1, J7.1, Q2.2 (C), Q4.2 (C), Q6.2 (C), Q8.2 (C), Q10.2 (C), Q12.2 (C), R30.2, R32.2, R38.2, R40.2, R52.2, R56.2, U1.8 (V+), U2.8 (V+), U3.8 (V+), U4.8 (V+), U5.8 (V+), U6.8 (V+), U7.8 (V+), U8.8 (V+), U9.8 (V+), U10.8 (V+), U12.8 (V+), U13.8 (V+), U14.8 (V+)

Notes on the sheet:
Power connection
Signal Conditioning board Audio connection
Unused opamp

Board: 2 copper layers, 146 parts (0 on the bottom side), 105 nets, no tracks yet.
