dario0603/AudioAnalogMixer/(commit log)

2026-11-10 Add README for Analog Audio Mixer project
    This README provides an overview of the Analog Audio Mixer project, detailing its design, system architecture, and ongoing development in LTspice and KiCad.
2026-11-11 Revise README for preamplifier circuit details
    Updated the README to reflect changes in the system architecture, including detailed descriptions of the microphone/line preamplifier circuit and its analysis. Added sections on transient and noise analysis for the microphone/line preamplifier.
2026-11-11 add Mixer simulations and updated README file
    [Mixer_circuit.kicad_sch]
2026-11-13 SignalConditioning - OneChannel - Mic-Line PCB first revision done
    [AudioMixer.kicad_pcb, Mixer_circuit.kicad_sch, Power_supply.kicad_sch, bom.csv, designators.csv, positions.csv]
